OrigamiTeam/AquaFlow/05. Design Mecanico v1.5/readme.md

Arquivo gerado no dia 02/10/2024, referente a versao 1.5 do projeto SmartFlow.

Montagem completa de todos os componentes mecanicos e eletronicos.

Fusion versão 2.0.20256 x86_64
