OrigamiTeam/AquaFlow/Display E-Paper/E-Paper_code/128x296px - V3.jpg

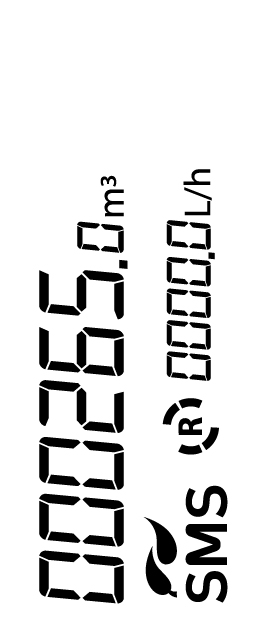
Display E-Paper/E-Paper_code/128x296px - V3.jpg
