OrigamiTeam/AquaFlow/01. AquaFlow v0.2/BOM AquaFlow v0.2 01.10.24.xlsx

Bill Of Materials for AquaFlow v0.2
Category | Quantity | References | Value | Link
Capacitors | 2 | C1, C2 | CAP CER 0805 22pF | https://www.tme.eu/pt/details/c0805c220j5gac/capacitores-mlcc-smd/kemet/c0805c220j5gactu/
Capacitors | 14 | C3, C4, C8, C9, C10, C11, C12, C16, C17, C26, C31, C32, C33, C41 | CAP CER 0805 100nF | https://www.tme.eu/pt/details/0805b104k500ct/capacitores-mlcc-smd/walsin/
Capacitors | 2 | C5, C23 | CAP CER 0805 10nF | https://www.tme.eu/pt/details/cl21b103kcannnc/capacitores-mlcc-smd/samsung/
Capacitors | 2 | C6, C22 | CAP CER 0805 2.2uF | https://www.tme.eu/pt/details/cl21b225kafnnne/capacitores-mlcc-smd/samsung/
Capacitors | 1 | C7 | CAP TANT CASE B 10uF/16V | https://www.tme.eu/pt/details/293d106x9025b2te3/capacitores-de-tantalo-smd/vishay/
Capacitors | 4 | C13, C14, C15, C21 | CAP CER 0805 1uF | https://www.tme.eu/pt/details/cl21b105kafnnng/capacitores-mlcc-smd/samsung/
Capacitors | 4 | C24, C25, C27, C28 | CAP CER 0805 12pF | https://www.tme.eu/pt/details/cc0805jrnpo9120/capacitores-mlcc-smd/yageo/cc0805jrnpo9bn120/
Capacitors | 1 | C29 | CAP CER 1206 100nF 1% | https://www.tme.eu/pt/details/gcm31c5c1h104fa16l/capacitores-mlcc-smd/murata/
Capacitors | 1 | C30 | CAP CER 0805 22uF | https://www.tme.eu/pt/details/cl21a226kpclrnc/capacitores-mlcc-smd/samsung/
Capacitors | 2 | C34, C35 | CAP CER 0805 1nF 1% | https://www.tme.eu/pt/details/08055a102fat2a/capacitores-mlcc-smd/kyocera-avx/
Resistors | 7 | R1, R3, R5, R6, R23, R27, R28 | RES 0805 10K | https://www.tme.eu/pt/details/smd0805-10k-1%25/resistencias-smd/royal-ohm/0805s8f1002t5e/
Resistors | 1 | R2 | RES 0805 1M | https://www.tme.eu/pt/details/smd0805-1m-1%25/resistencias-smd/royal-ohm/0805s8f1004t5e/
Resistors | 1 | R4 | RES 0805 100R | https://www.tme.eu/pt/details/smd0805-100r-1%25/resistencias-smd/royal-ohm/0805s8f1000t5e/
Resistors | 1 | R7 | RES 0805 200mR | https://www.tme.eu/pt/details/erj6bsfr20v/resistencias-smd/panasonic/
Resistors | 1 | R8 | RES 0805 4K7 | https://www.tme.eu/pt/details/smd0805-4k7-1%25/resistencias-smd/royal-ohm/0805s8f4701t5e/
Resistors | 1 | R11 | RES 0805 1K | https://www.tme.eu/pt/details/smd0805-1k-1%25/resistencias-smd/royal-ohm/0805s8f1001t5e/
Resistors | 1 | R20 | RES 0805 1K 25ppm/C 0.1% | https://www.tme.eu/pt/details/era6aeb102v/resistencias-smd/panasonic/
Resistors | 2 | R21, R22 | RES 0805 680R | https://www.tme.eu/pt/details/smd0805-680r-1%25/resistencias-smd/royal-ohm/0805s8f6800t5e/
Resistors | 1 | R29 | RES 0805 220R | https://www.tme.eu/pt/details/smd0805-220r-1%25/resistencias-smd/royal-ohm/0805s8f2200t5e/
Resistors | 1 | PTC1 | PTC SMD 1206 250mA 15V | https://www.tme.eu/pt/details/0zcj0025af2e/fusiveis-de-polimero-smd/bel-fuse/
Integrated Circuits | 1 | U1 | 16-HTSSOP DRV8833PWPR | https://www.tme.eu/pt/details/drv8833pw/drivers-de-motor-e-pwm/texas-instruments/
Integrated Circuits | 1 | U3 | 32-TQFP ATMEGA328PB-AU SMD | https://www.tme.eu/pt/details/atmega328pb-au/familia-avr-8-bit/microchip-technology/
Integrated Circuits | 1 | U4 | SOT-23-5 LP2985AIM5-3.3/NOPB | https://www.tme.eu/pt/details/lp2985aim5-3.3nopb/reguladores-de-tensao-nao-regulada-ldo/texas-instruments/lp2985aim5-3-3-nopb/
Integrated Circuits | 1 | U5 | 32-TQFP Exposed Pad MAX35103EHJ+ | https://www.digikey.pt/pt/products/detail/analog-devices-inc-maxim-integrated/MAX35103EHJ/6568908 https://www.digikey.pt/pt/products/detail/analog-devices-inc-maxim-integrated/MAX35103EHJ-T/7392205
Transistors | 1 | Q1 | SOT-23 BC817 | https://www.tme.eu/pt/details/bc817-25-dio/transistores-npn-smd/diotec-semiconductor/bc817-25/
Diodes | 1 | D3 | SMA US1M | https://www.tme.eu/pt/details/us1mtr-smc/diodos-universais-smd/smc-diode-solutions/us1mtr/
Diodes | 1 | D9 | SMB SMBJ12A | https://www.tme.eu/pt/details/p6smbj12a-dio/diodos-transil-smd-unidirecionais/diotec-semiconductor/p6smbj12a/
Diodes | 1 | D-PWR | LED SMD 0805 | https://www.tme.eu/pt/details/ll-s170pgc-g5-1a/diodos-led-smd-de-cores/luckylight/
Connectors | 2 | J1, RTD1 | S2B-PH-SM4-TB | https://www.tme.eu/pt/details/s2b-ph-sm4-tb/conectores-de-sinal-raster-2-00mm/jst/s2b-ph-sm4-tb-lf-sn/
Connectors | 1 | J2 | CONN-SIL6 | DNP (do-not-populate)
Connectors | 1 | J3 | CONN-SIL10 | https://www.tme.eu/pt/details/zl211-20kg-s/pinos-tipo-header/connfly/ds1022-1-20ruf1-1/
Connectors | 1 | J4 | S4B-PH-SM4-TB | https://www.tme.eu/pt/details/s4b-ph-sm4-tb/conectores-de-sinal-raster-2-00mm/jst/s4b-ph-sm4-tb-lf-sn/
Connectors | 1 | J5 | S5B-PH-SM4-TB | https://www.tme.eu/pt/details/s5b-ph-sm4-tb/conectores-de-sinal-raster-2-00mm/jst/s5b-ph-sm4-tb-lf-sn/
Connectors | 1 | J6 | S3B-PH-SM4-TB | https://www.tme.eu/pt/details/s3b-ph-sm4-tb/conectores-de-sinal-raster-2-00mm/jst/s3b-ph-sm4-tb-lf-sn/
LCD | 1 | LCD1 | NHD-C12832A1Z-FSW-FBW-3V3 | https://www.tme.eu/pt/details/nhd-c12832a1z-fwf3/indicadores-graficos-lcd/newhaven-display-international/nhd-c12832a1z-fsw-fbw-3v3/
Miscellaneous | 1 | S1 | CHAVE TACT PTS636 | https://www.tme.eu/pt/details/pts636sk50jsmtrlfs/microcomutadores-tact/c-k/pts636-sk50j-smtr-lfs/
Miscellaneous | 1 | X1 | HC-49 8MHz | https://www.tme.eu/pt/details/8.00m-smdhc49s/cristais-de-quartzo-smd/yic/
Miscellaneous | 1 | X2 | HC-49 4MHz | https://www.tme.eu/pt/details/4.00m-smdhc49s/cristais-de-quartzo-smd/yic/
Miscellaneous | 1 | X3 | SMD 9CAA32768122TF70QT | https://www.tme.eu/pt/details/32.768k12.5pi_3215/cristais-de-quartzo-smd/yic/32-768k12-5pi-3215e/
