OrigamiTeam/AquaFlow/02. Modulo Protocolo LoRa v0.1/BOM Modulo Protocolo LoRa v0.1 01.10.24.xlsx

Bill Of Materials for Modulo Protocolo LoRa v0.1
Category | Quantity | References | Value | Link
Integrated Circuits | 1 | U1 | RFM95W LORA MODULE | https://www.tme.eu/pt/details/rfm95cw-868s2/modulos-de-rf/hope-microelectronics/
Connectors | 1 | J1 | DS1024-1*10R0 | https://www.tme.eu/pt/details/zl263-10sg/pinos-tipo-header/connfly/ds1024-1-10r0/
