OrigamiTeam/AquaFlow/Arquivos Auxiliares/T-2Y2W539394A-5sets-SmartFlow+v0.1+BOM+PCBWay(2024-05-27).xlsx

PCBWay Bom Quotation, Product No.:T-2Y2W539394A
Item # | *Designator | *Qty | *Mfg Part # | *Package/Footprint | *Unit Price(5 sets) | *Total | *Delivery Time | *Actual Purchase Mfg Part # | *PCBWay Note | Customer Reply
1 | C1,C2 | 2 | 22pF | RC0805 | $0.050 | $0.500 |  | CC0805JRNPOYBN220
2 | C3,C4,C5,C8,C16,C19,C26,C31,C32,C33,C39,C40,C41 | 13 | 100nF | RC0805 | $0.016 | $1.040 |  | CC0805ZRY5V9BB104
3 | C6,C9,C10,C17,C20,C23,C37 | 7 | 10nF | RC0805 | $0.011 | $0.385 |  | CC0805KRX7R8BB103
4 | C7,C42 | 2 | 10uF | RC0805 | $0.084 | $0.840 |  | CC0805KKX5R7BB106
5 | C11,C12 | 2 | 51pF | RC0805 | $0.050 | $0.500 |  | CC0805JRNPO9BN510
6 | C13,C34,C35 | 3 | 1nF 1% | RC0805 | $0.050 | $0.750 |  | CC0805FRNPO9BN102
7 | C14,C15 | 2 | 300pF | RC0805 | $0.076 | $0.760 |  | CC0805FRNPO9BN301
8 | C18,C21 | 2 | 1uF | RC0805 | $0.034 | $0.340 |  | CC0805KKX7R6BB105
9 | C22,C43 | 2 | 2.2uF | RC0805 | $0.082 | $0.820 |  | CC0805ZKY5V8BB225
10 | C24,C25,C27,C28 | 4 | 12pF | RC0805 | $0.010 | $0.200 |  | CC0805JRNPO9BN120
11 | C29 | 1 | 100nF 1206 1% | RC1206 | $1.239 | $6.195 |  | GRM31C5C1H104FA01L
12 | C30,C38 | 2 | 22uF | RC0805 | $0.092 | $0.920 |  | CC0805ZKY5V5BB226
13 | C36 | 1 | 10uF 1206 | RC1206 | $0.147 | $0.735 |  | CC1206KKX5R8BB106
14 | C44 | 1 | 6.8pF | RC0805 | $0.050 | $0.250 |  | CC0805CRNPO9BN6R8
15 | PTC1,PTC2 | 2 | 1206 250mA | RC1206 | $0.248 | $2.480 |  | 0ZCJ0025AF2E
16 | R1,R3,R5,R23,R25,R27,R28,R32,R33,R34 | 10 | 10K | RC0805 | $0.005 | $0.250 |  | RC0805JR-0710KL
17 | R2 | 1 | 1M | RC0805 | $0.036 | $0.180 |  | RC0805JR-071ML
18 | R4,R15,R16,R17 | 4 | 33R | RC0805 | $0.003 | $0.060 |  | RC0805JR-0733RL
19 | R6,R7 | 2 | 10M | RC0805 | $0.006 | $0.060 |  | RC0805FR-0710ML
20 | R8 | 1 | 5K36 1% | RC0805 | $0.050 | $0.250 |  | AC0805FR-075K36L
21 | R9,R10 | 2 | 1K 1% | RC0805 | $0.026 | $0.260 |  | RC0805FR-071KL
22 | R11,R12 | 2 | 0R | RC0805 | $0.006 | $0.060 |  | RC0805JR-070RL
23 | R13,R14,R18,R24,R26,R29 | 6 | 200R | RC0805 | $0.025 | $0.750 |  | AC0805JR-07200RL
24 | R19 | 1 | 102K 1% | RC0805 | $0.042 | $0.210 |  | RTT051023FTP
25 | R20 | 1 | 1K 25ppm/C 0.1% | RC0805 | $0.147 | $0.735 |  | RT0805BRD071KL
26 | R21,R22 | 2 | 680R | RC0805 | $0.006 | $0.060 |  | RC0805FR-07680RL
27 | R30 | 1 | 45K3 1% | RC0805 | $0.084 | $0.420 |  | RT0805FRE0745K3L
28 | R31 | 1 | 10K 1% | RC0805 | $0.042 | $0.210 |  | AC0805FR-0710KL
29 | R35 | 1 | 51K1 1% | RC0805 | $0.013 | $0.065 |  | RC0805FR-0751K1L
30 | D1,D4,D5,D-PWR | 4 | LED 0805 | RC0805 | $0.005 | $0.100 |  | XL-2012UGC | https://atta.szlcsc.com/upload/public/pdf/source/20240218/10747BE0D5713A87F194700A6CFFD889.pdf
31 | D3,D6 | 2 | US1M | SMA | $0.126 | $1.260 |  |  | Manufacturer：SMC.Package：DO-214AC（SMA）
32 | D7 | 1 | SMBJ5.0A | SMB | $0.408 | $2.040 |  |  | Manufacturer: SMC.Package：DO-214AA（SMB）
33 | D9 | 1 | SMBJ12A | SMB | $0.214 | $1.070 |  |  | Manufacturer:Littelfuse.Package：SMB(DO-214AA)
34 | FB1,FB2,FB3 | 3 | BK1608HS600 | RC0603 | $0.105 | $1.575 |  | BK1608HS600-T | Package：0603
35 | U1 | 1 | TDC1000PW | 28-TSSOP | $3.045 | $15.225
36 | U2 | 1 | TDC7200PW | 14-TSSOP | $1.376 | $6.880
37 | U3 | 1 | ATMEGA328PB-AU SMD | 32-TQFP | $1.859 | $9.295
38 | U4 | 1 | LP2985AIM5-3.3/NOPB | SOT-23-5 | $0.410 | $2.050
39 | U5 | 1 | MAX35103EHJ+ | 32-TQFP Exposed Pad | $10.248 | $51.240
40 | U6 | 1 | MAX8902BATA+T | 8-WFDFN Exposed Pad | $0.557 | $2.785
41 | U7 | 1 | ESP32-WROOM-32E | 38-SMD Module | $3.590 | $17.950 |  | ESP32-WROOM-32E-N16
42 | U10 | 1 | LP2980IM5X-ADJ/NOPB | SOT-23-5 | $1.092 | $5.460
43 | S1,S2 | 2 | PTS636 |  | $0.158 | $1.580 | 7-10 Workdays | PTS636 SL50 SMTR LFS
44 | X1 | 1 | 8MHz | HC-49 | $0.222 | $1.110 |  | ABLS-8.000MHZ-B4-T
45 | X2 | 1 | 4MHz | HC-49 | $0.232 | $1.160 |  | ABLS-4.000MHZ-B2-T
46 | X3 | 1 | ABS25-32.768KHZ-T | 4-SOJ | $0.408 | $2.040
47 | Y1 | 1 | ASEMB-8.000MHZ-XY-T | 4-SMD | $5.226 | $26.130 | 7-10 Workdays
 |  |  |  |  | Component Cost | $169.24
