OrigamiTeam/AquaFlow/02. Modulo Protocolo LoRa v0.1/Modulo Protocolo LoRa v0.2.STEP

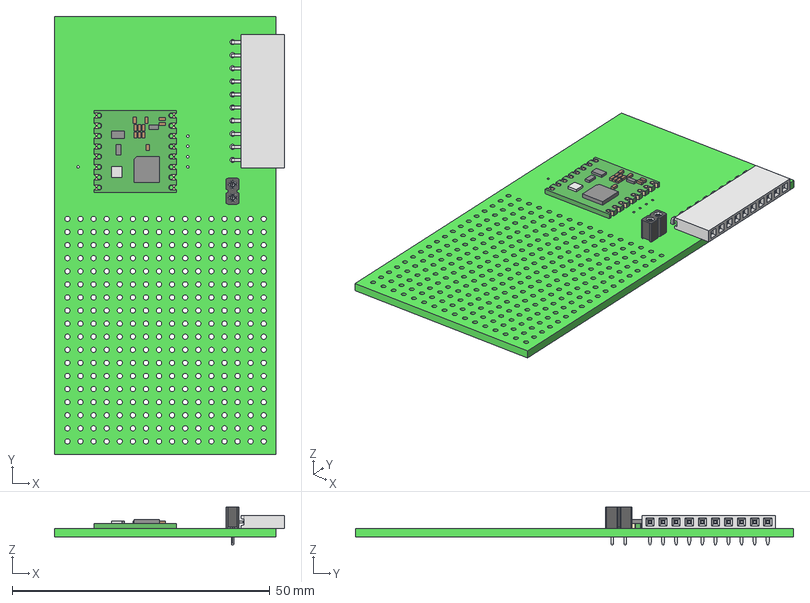
[picture p2: CAD file, 2024-09-12]
02. Modulo Protocolo LoRa v0.1/Modulo Protocolo LoRa v0.2.STEP
44.7 x 85.0 x 7.37 mm
Layer_1
=>[0:1:1:3] x 2
=>[0:1:1:4] x 2
=>[0:1:1:5] x 2
=>[0:1:1:6] x 2
=>[0:1:1:7] x 2
=>[0:1:1:8] x 2
=>[0:1:1:9] x 2
=>[0:1:1:10] x 2
=>[0:1:1:11] x 2
=>[0:1:1:12] x 2
=>[0:1:1:13] x 2
=>[0:1:1:14]
=>[0:1:1:15]
=>[0:1:1:16]
=>[0:1:1:17]
=>[0:1:1:18]
=>[0:1:1:19]
=>[0:1:1:20]
=>[0:1:1:21]
=>[0:1:1:22]
=>[0:1:1:23]
=>[0:1:1:24]
=>[0:1:1:25]
=>[0:1:1:26]
=>[0:1:1:27]
=>[0:1:1:28]
=>[0:1:1:29]
=>[0:1:1:30]
=>[0:1:1:31]
=>[0:1:1:32]
=>[0:1:1:33]
=>[0:1:1:34]
=>[0:1:1:35]
