OrigamiTeam/AquaFlow/01. AquaFlow v0.2/AquaFlow v0.2 SCH 03.09.24.PDF

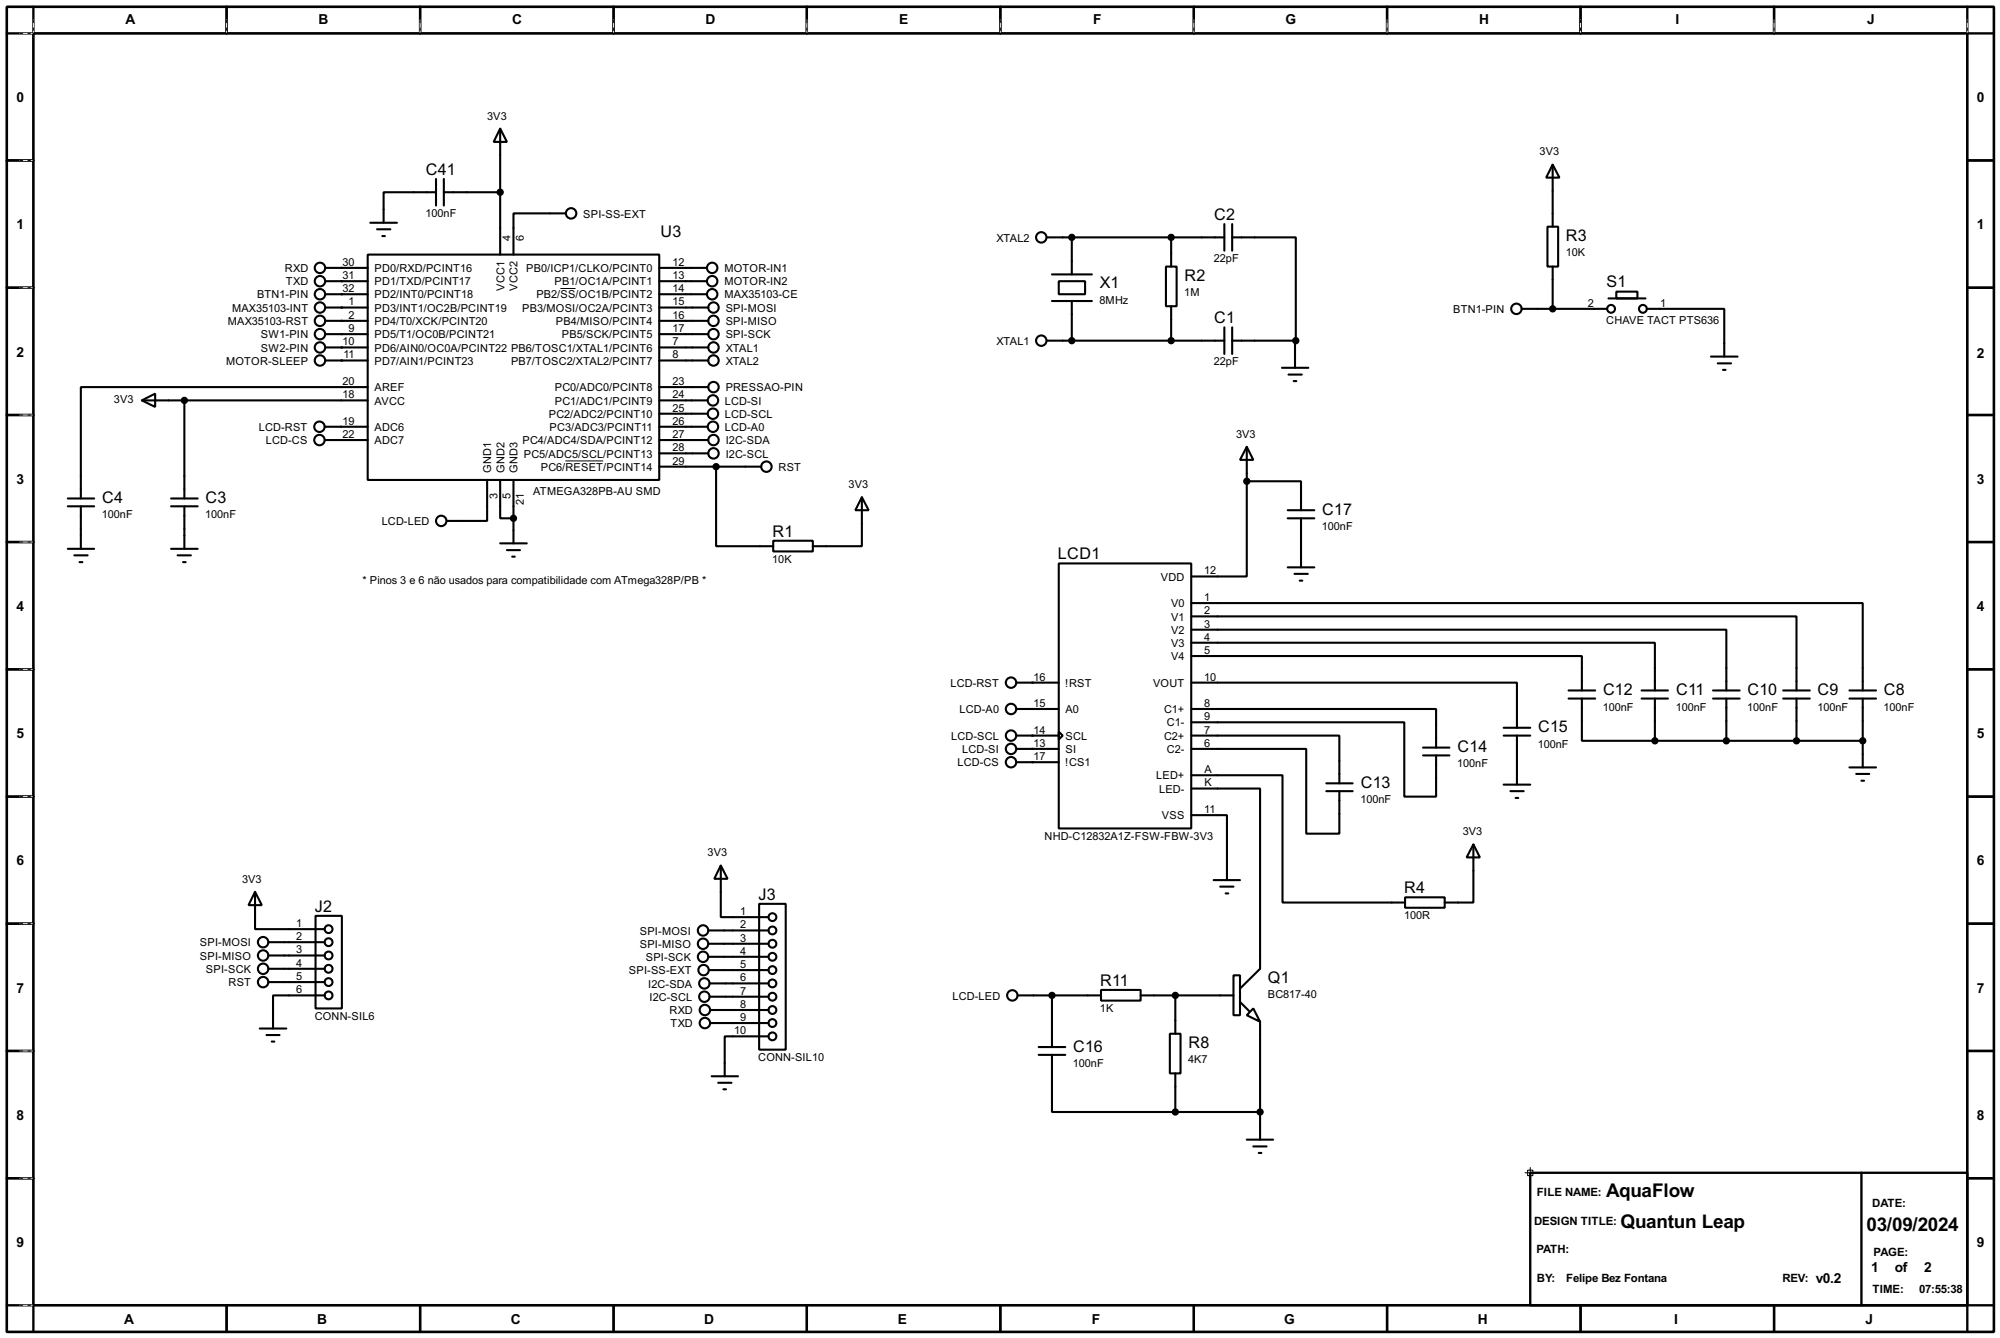
[picture p3: page 1]

* Pinos 3 e 6 não usados para compatibilidade com ATmega328P/PB *

2 V2
3 V3
4 V4 5

DESIGN TITLE:Quantun Leap

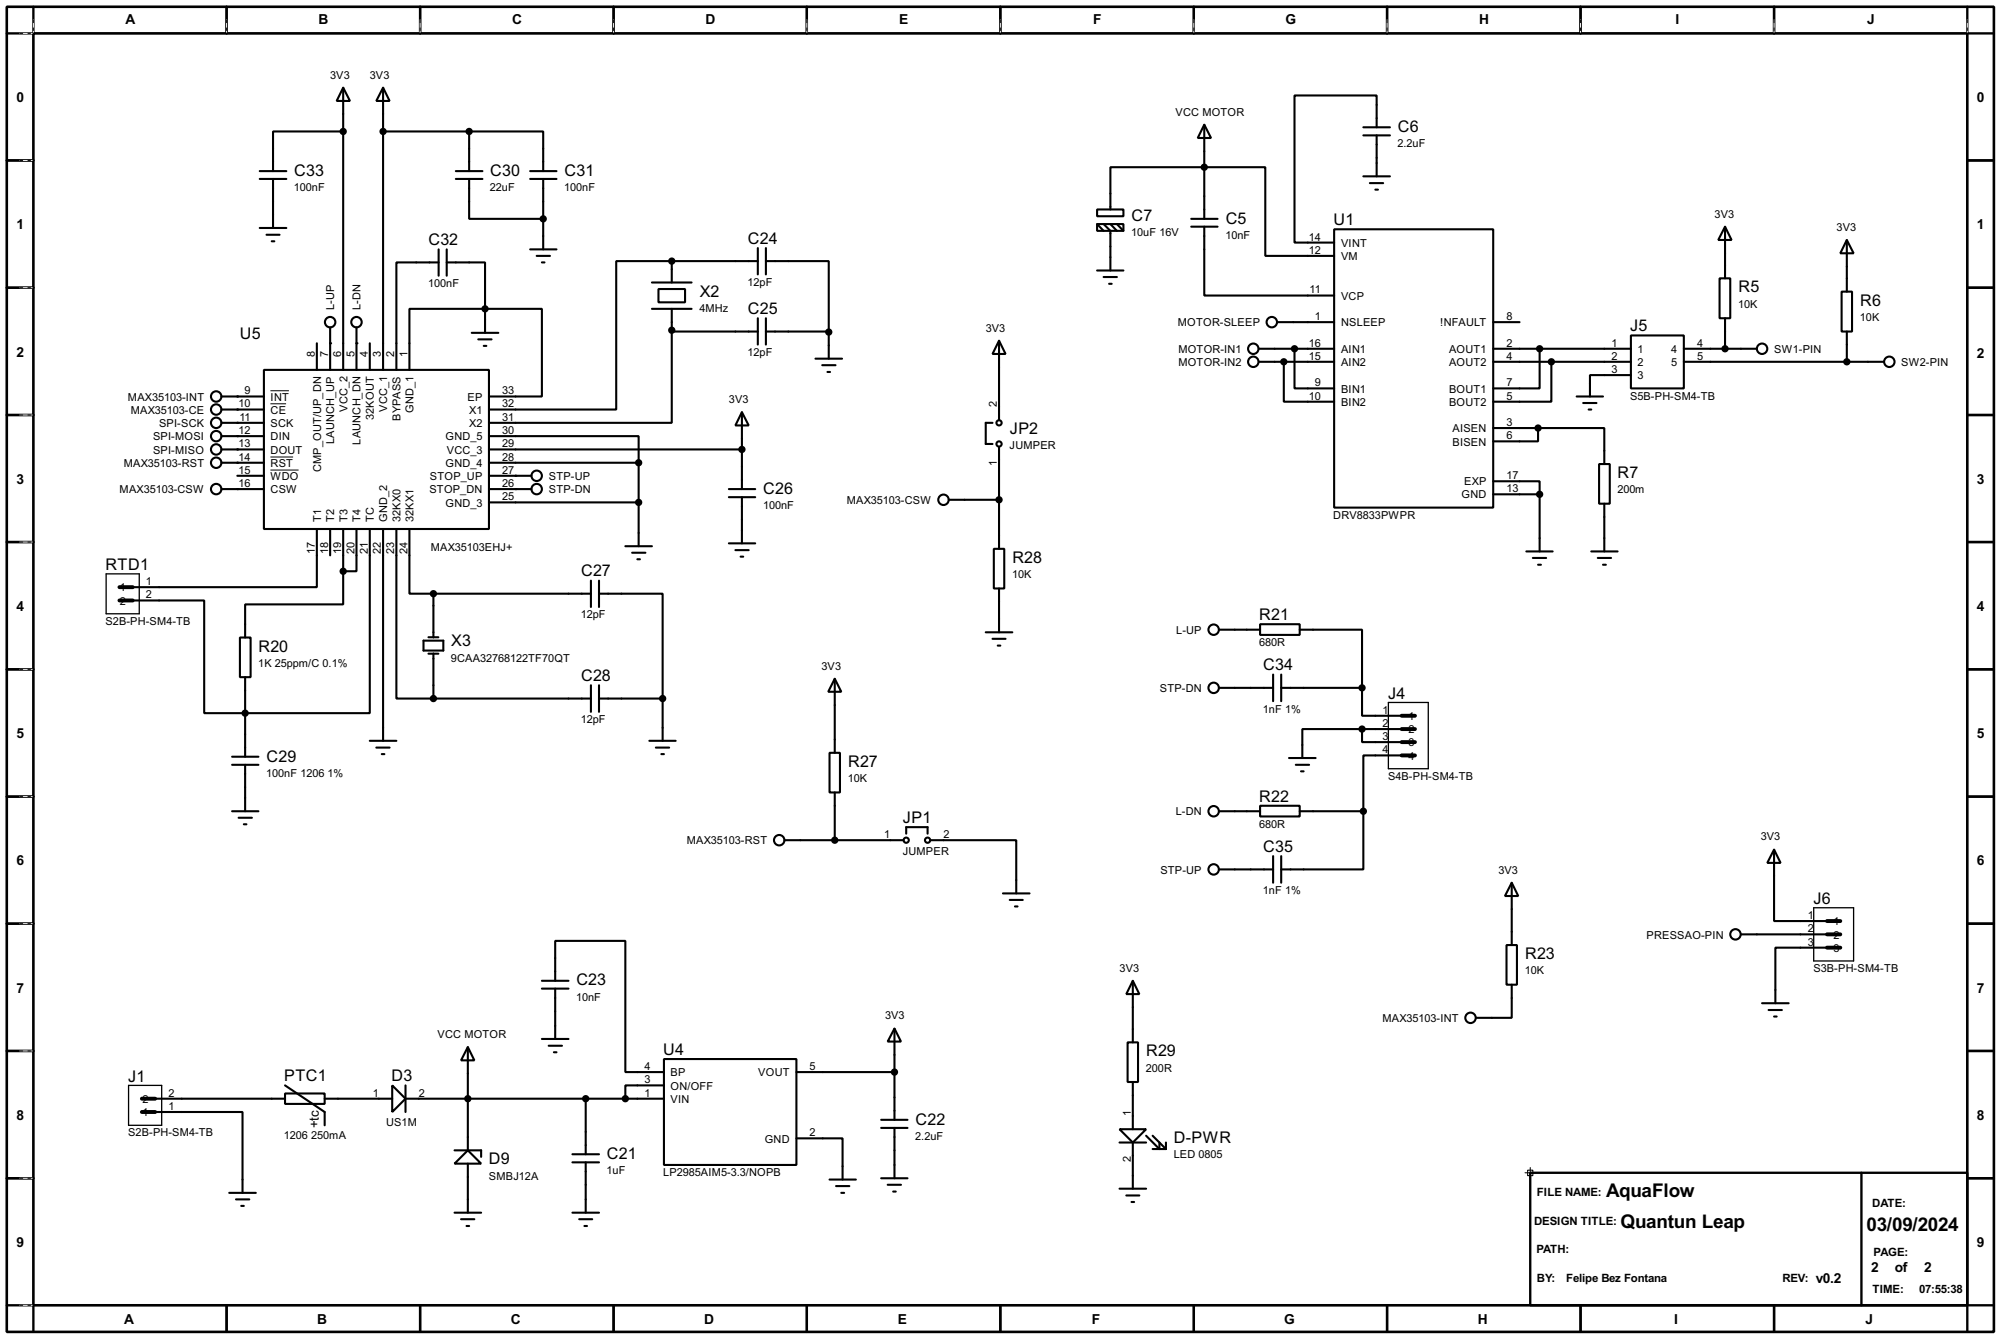
[picture p4: page 2]

4MHz

SPI-MOSI SPI-MISO MAX35103-RST MAX35103-CSW

30 VCC_3
29 GND_4

DESIGN TITLE:Quantun Leap
