OrigamiTeam/AquaFlow/PCB SmartFlow v0.1/SmartFlow v0.1 SCH.PDF

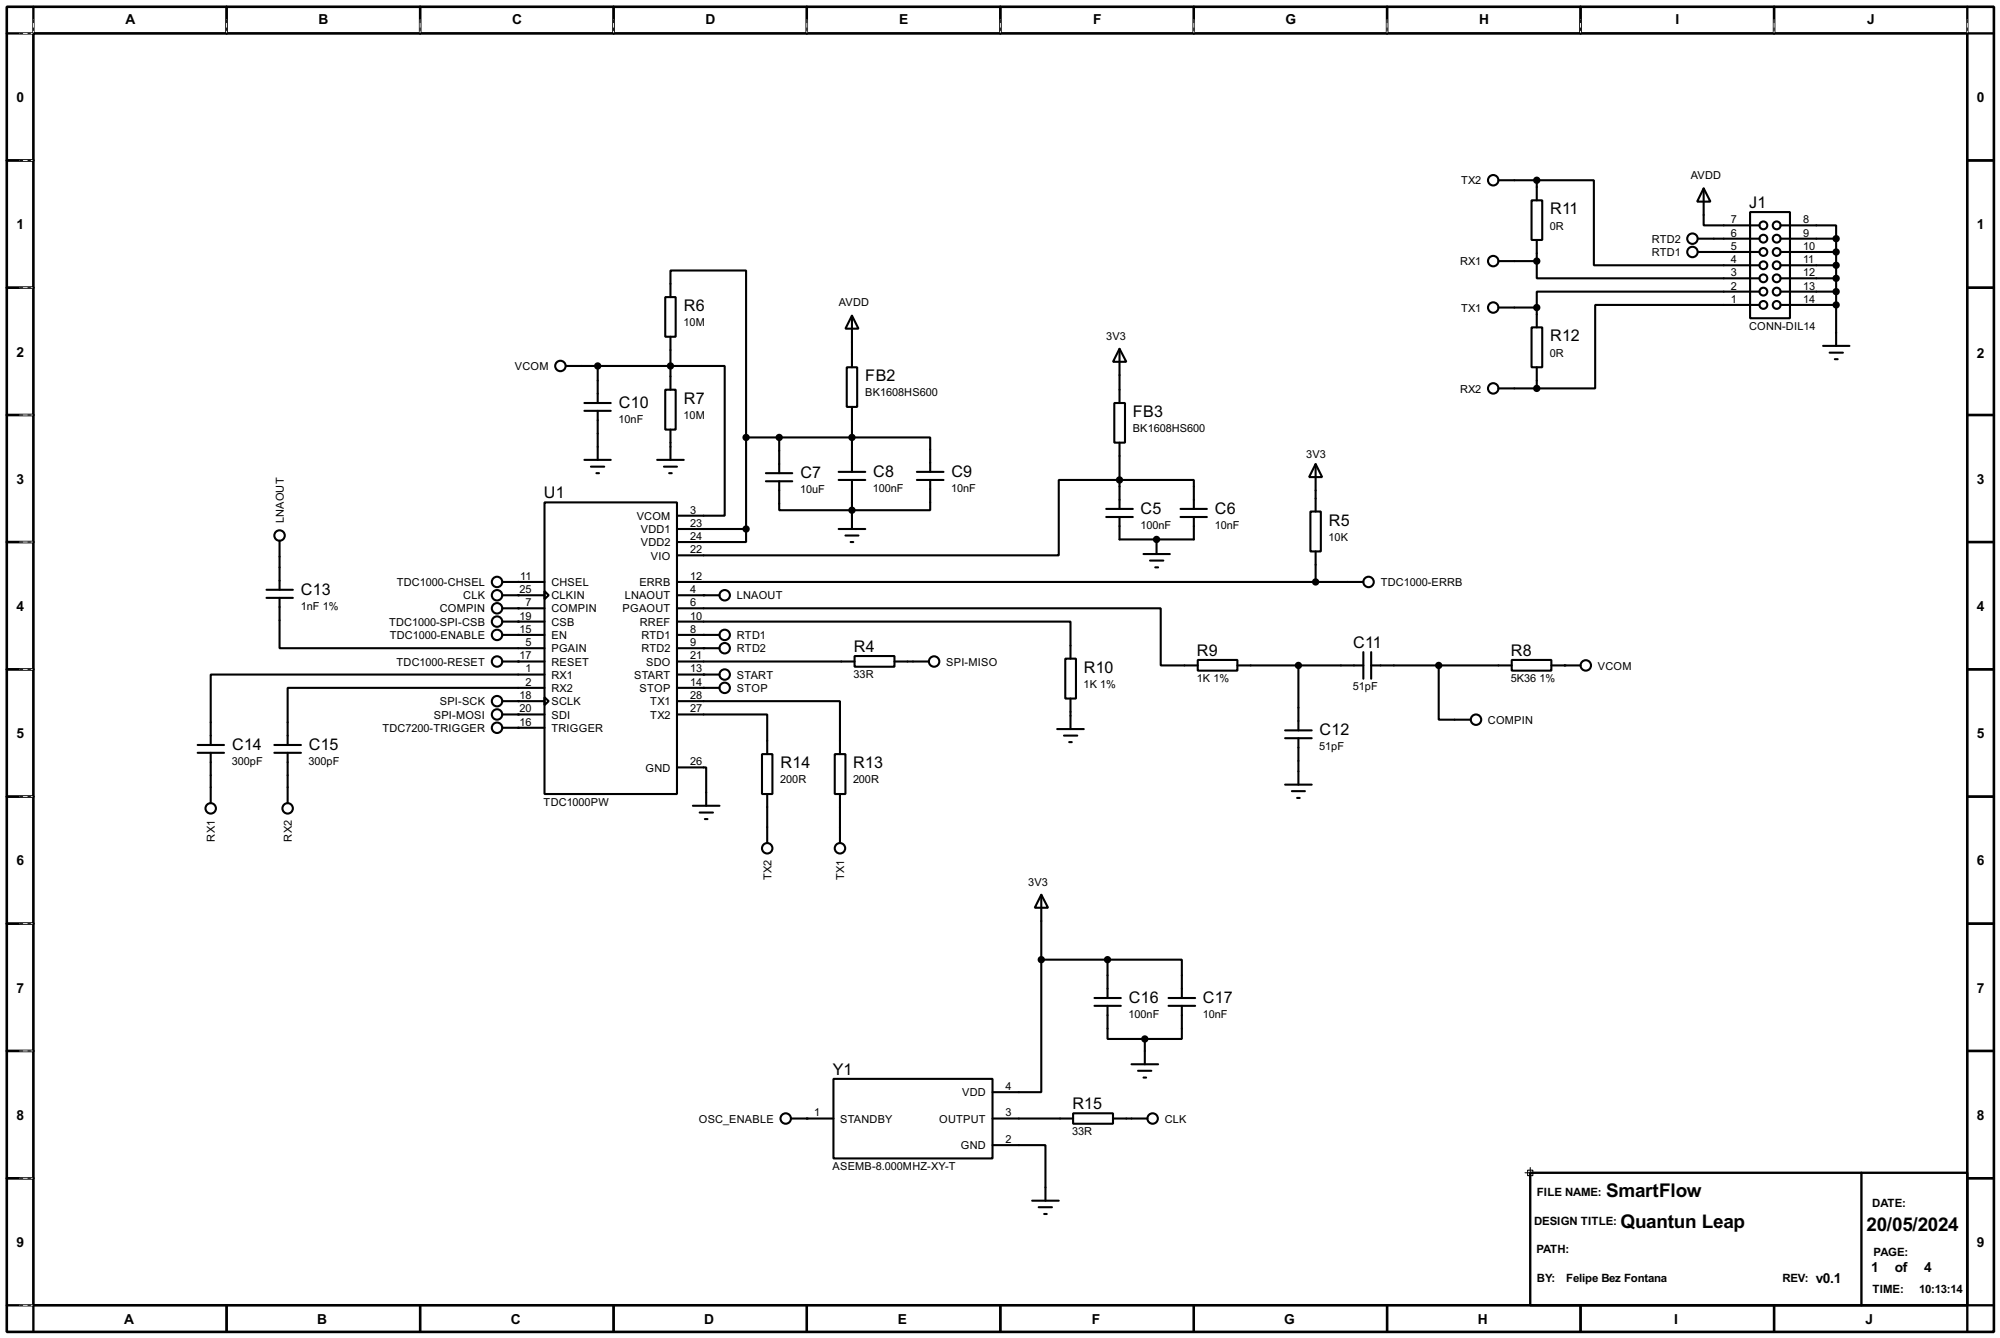
[picture p5: page 1]

SPI-MOSI SPI-SCK | 28 TX2

DESIGN TITLE:Quantun Leap

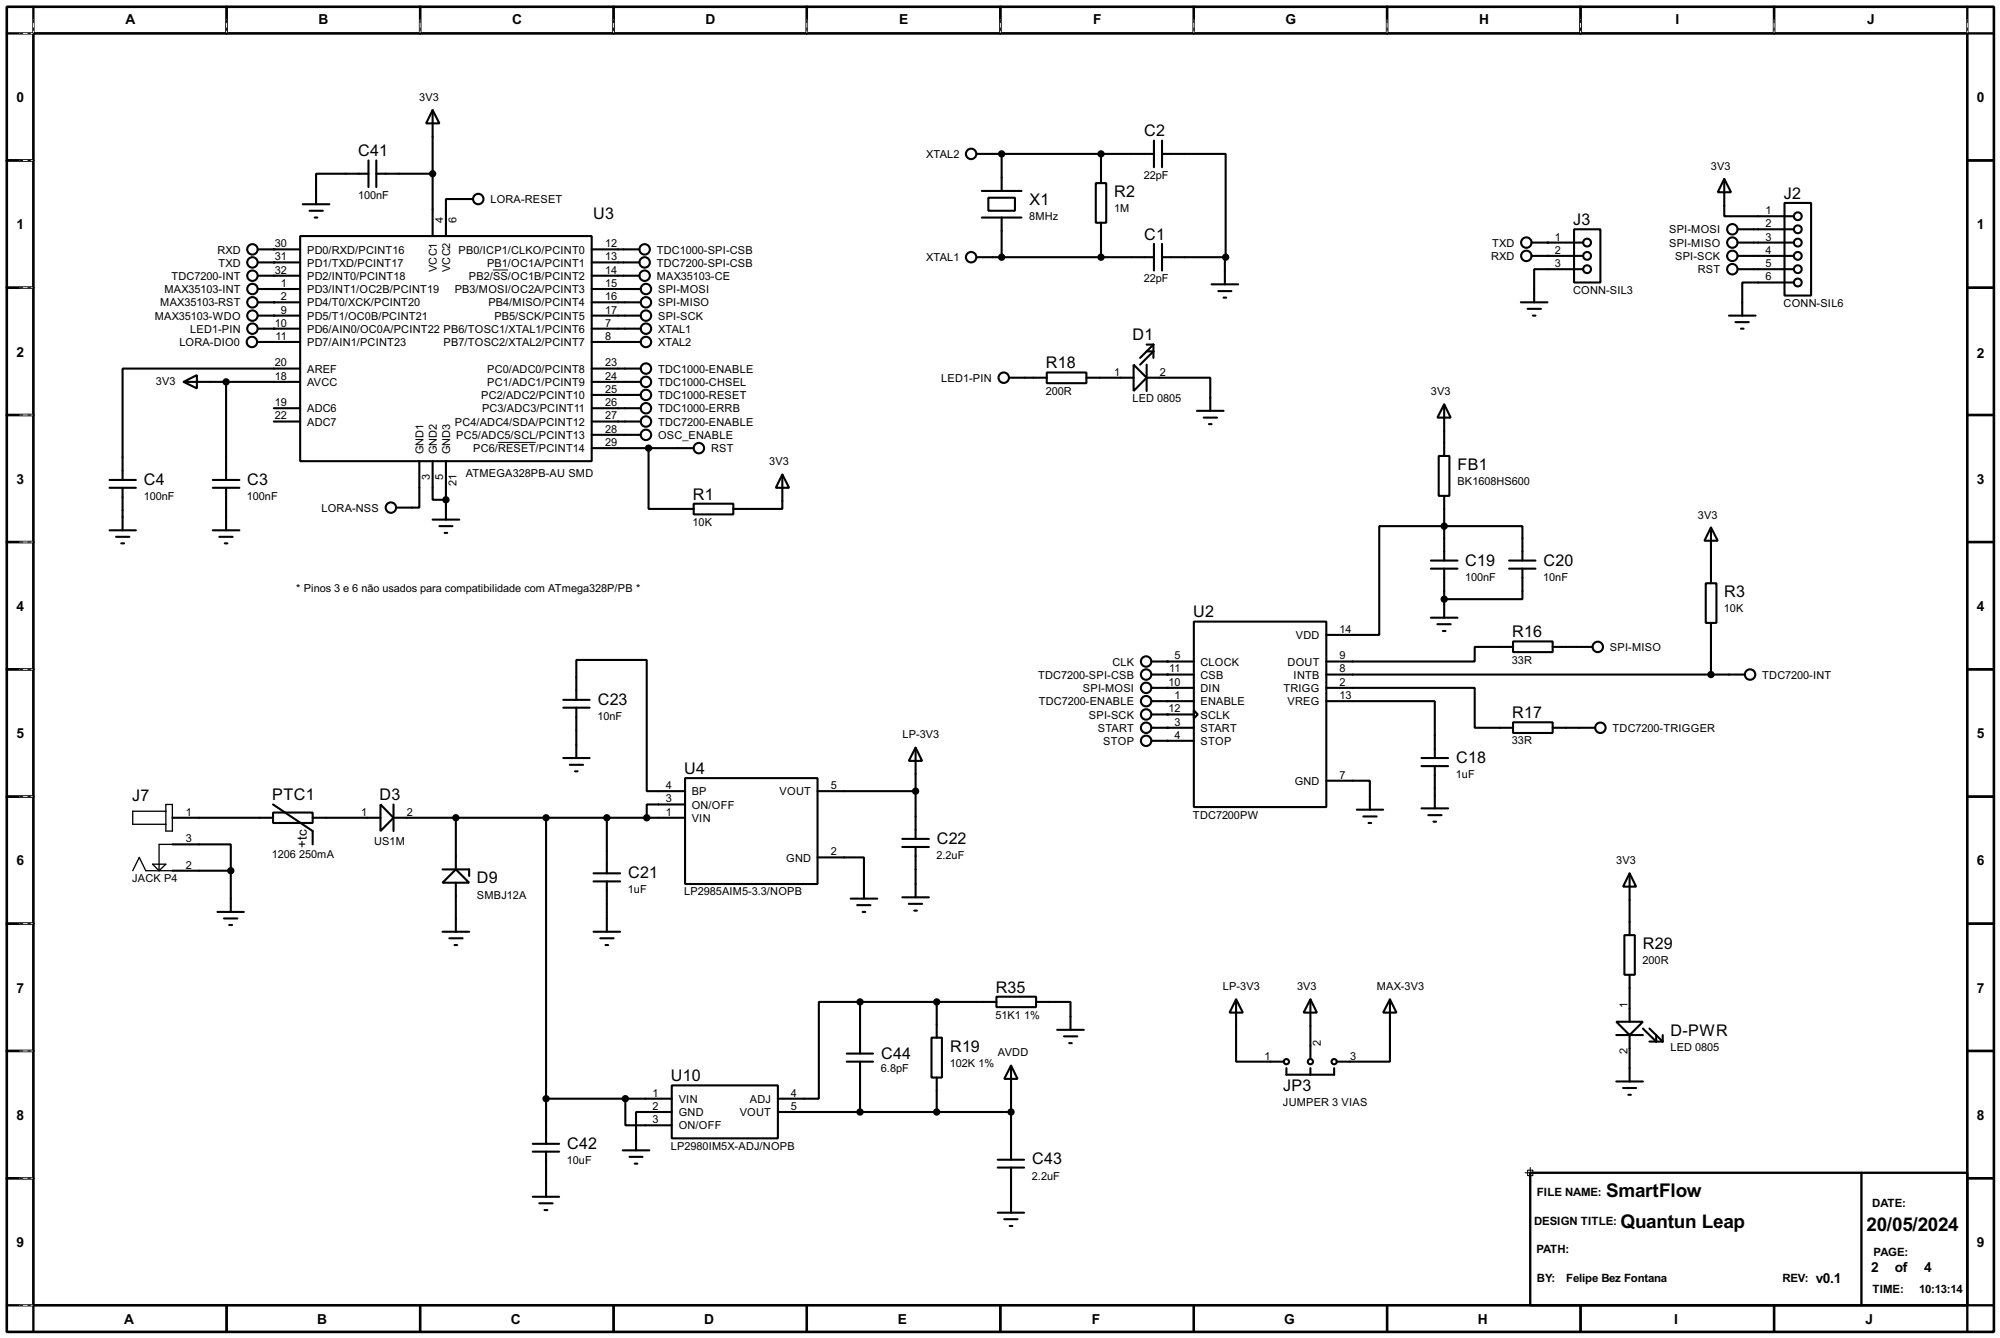
[picture p6: page 2]

* Pinos 3 e 6 não usados para compatibilidade com ATmega328P/PB *

DESIGN TITLE:Quantun Leap

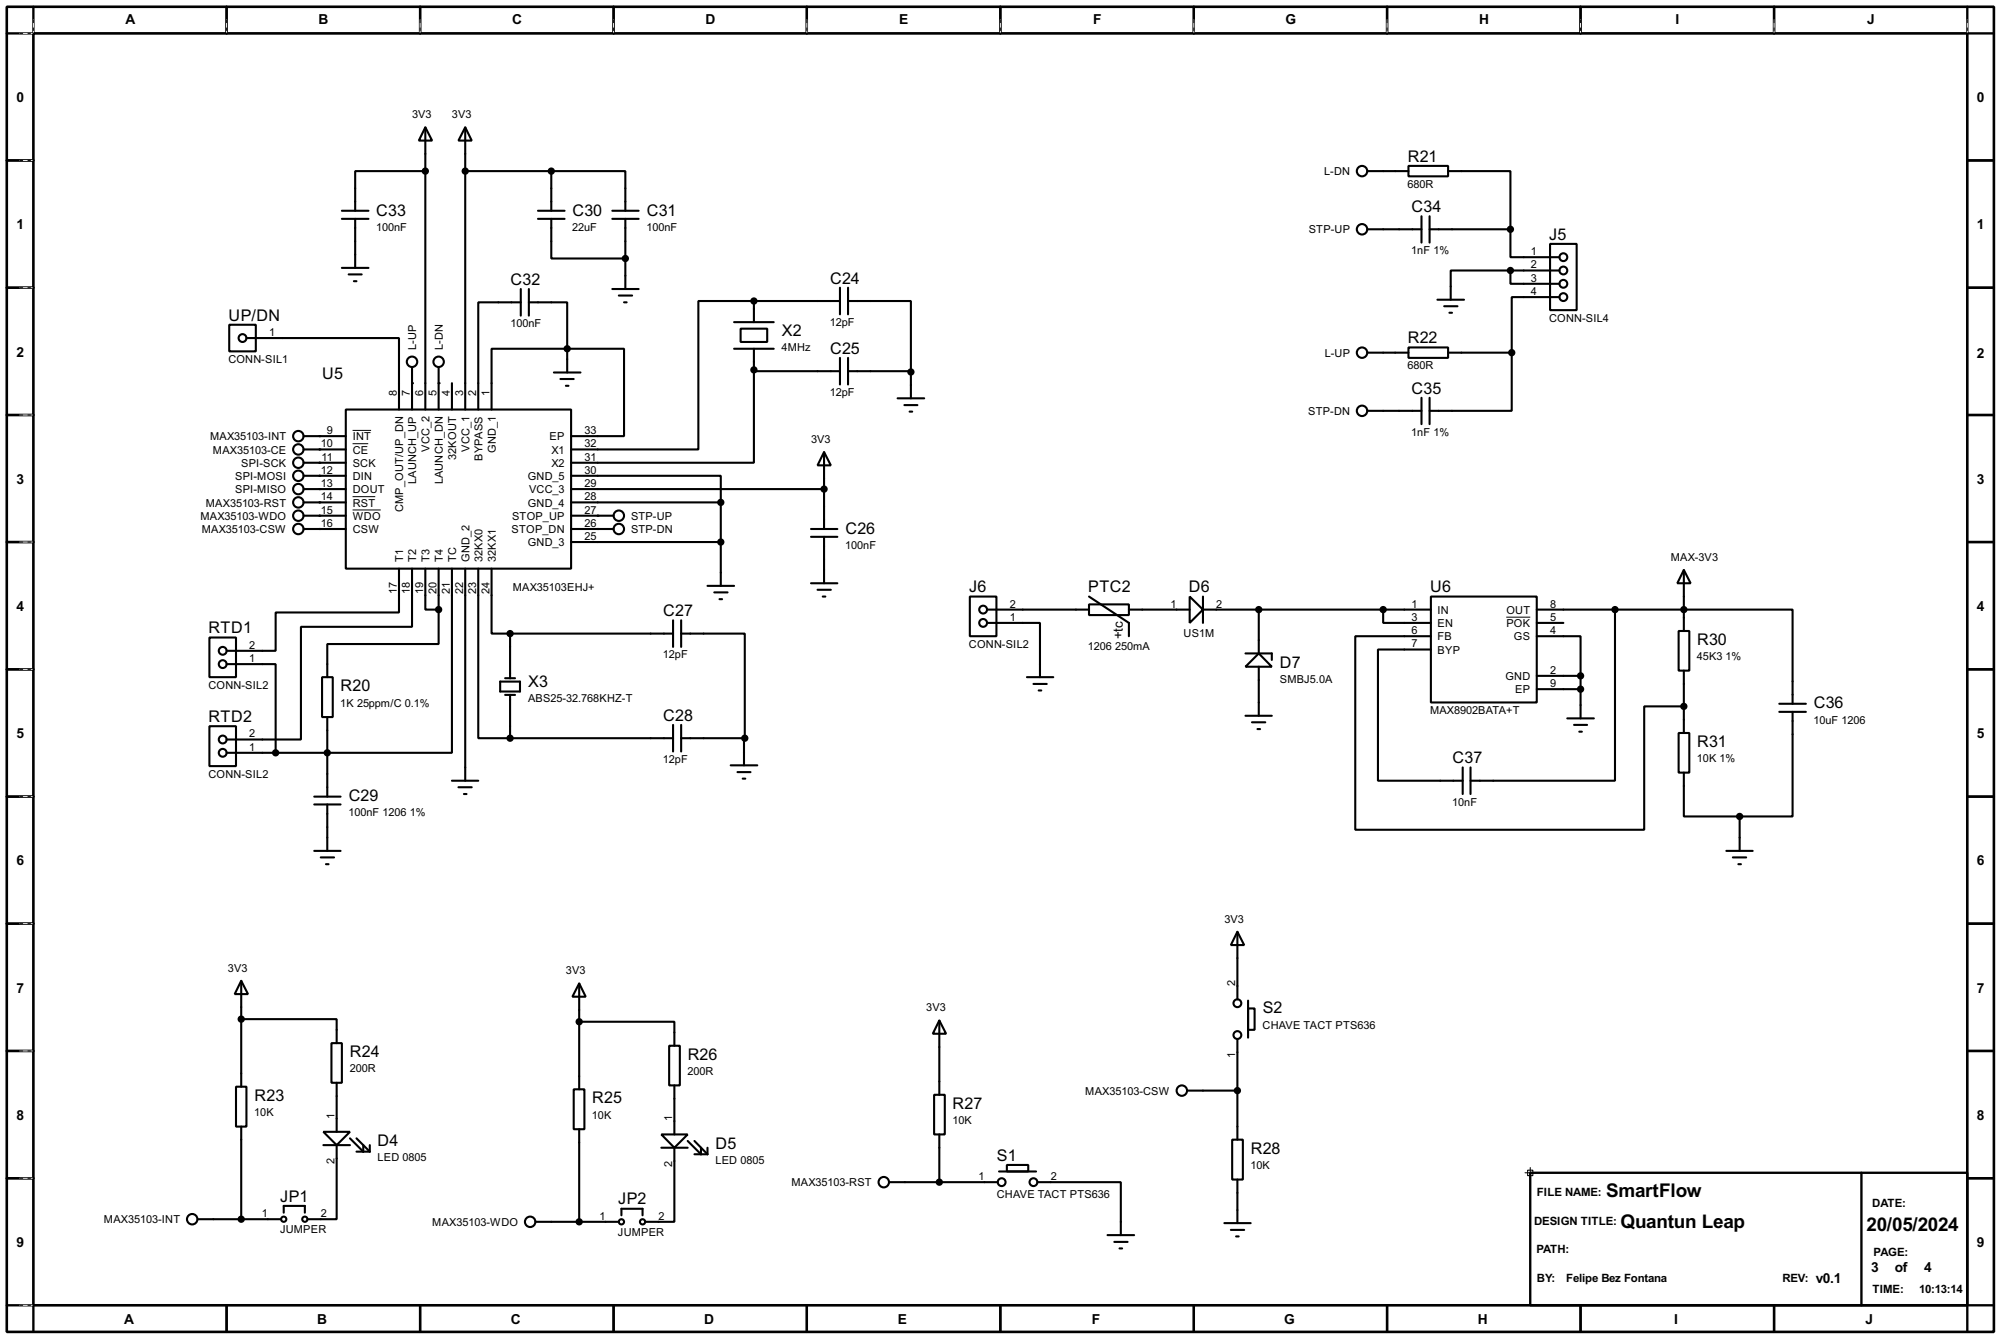
[picture p7: page 3]

STP-DN MAX35103-INT MAX35103-CE

SPI-MOSI SPI-MISO MAX35103-RST MAX35103-WDO MAX35103-CSW

DESIGN TITLE:Quantun Leap

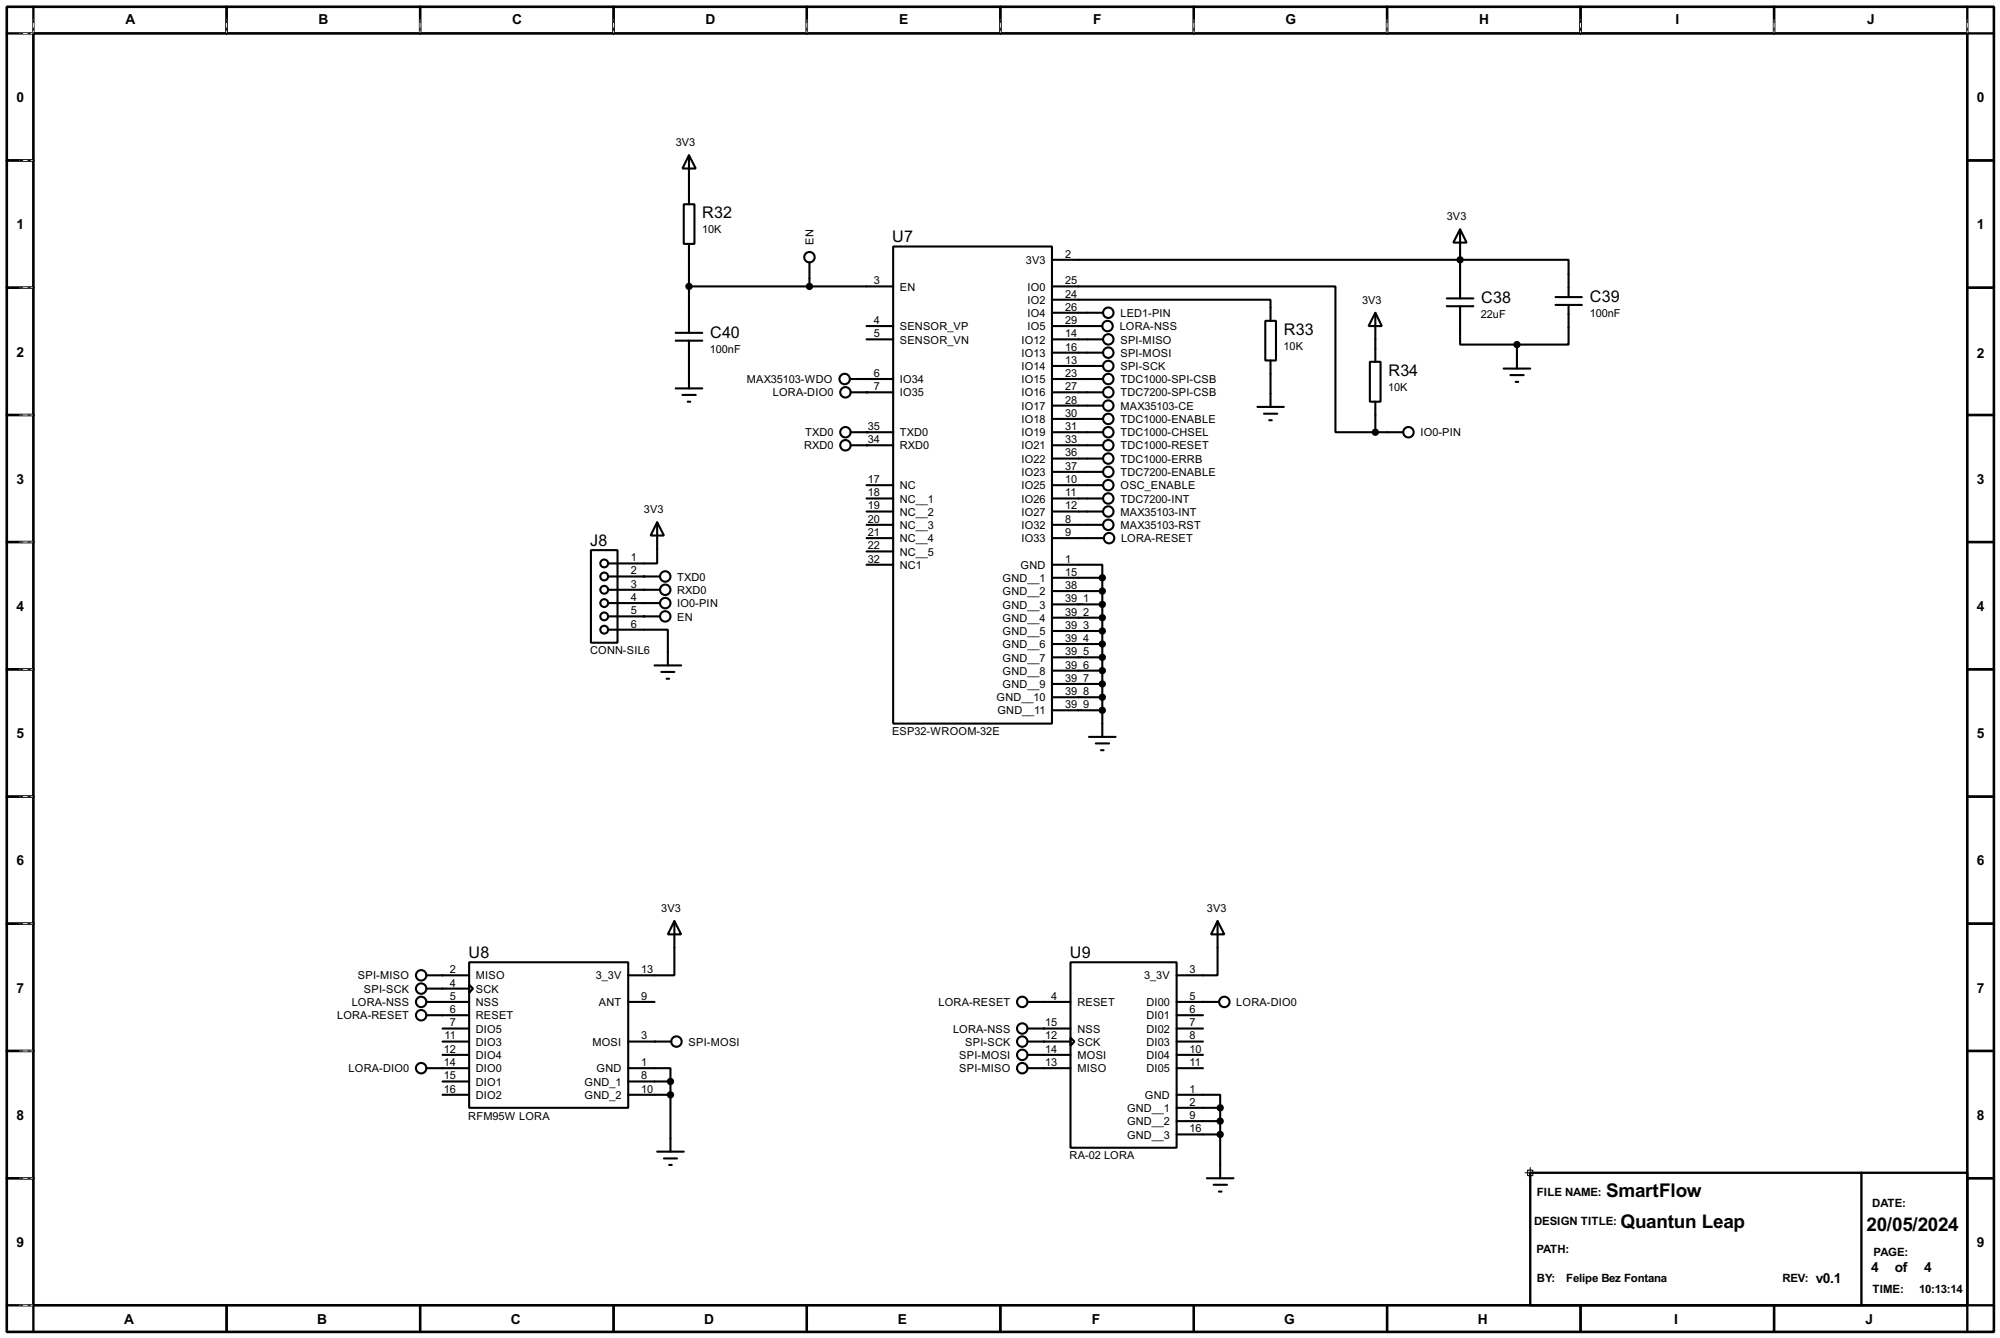
[picture p8: page 4]

25
24
26

DESIGN TITLE:Quantun Leap
