OrigamiTeam/AquaFlow/(list of files, drawings)

Other design files:
01. AquaFlow v0.2/AquaFlow v0.2.pdsprj
01. AquaFlow v0.2/Project Backups/AquaFlow v0.2 [20240903, 07-31-48].pdsprj
01. AquaFlow v0.2/Project Backups/AquaFlow v0.2 [20240903, 07-32-56].pdsprj
01. AquaFlow v0.2/Project Backups/AquaFlow v0.2 [20240903, 07-33-39].pdsprj
01. AquaFlow v0.2/Project Backups/AquaFlow v0.2 [20240903, 07-35-05].pdsprj
01. AquaFlow v0.2/Project Backups/AquaFlow v0.2 [20240903, 07-35-08].pdsprj
01. AquaFlow v0.2/Project Backups/AquaFlow v0.2 [20240903, 07-51-51].pdsprj
01. AquaFlow v0.2/Project Backups/AquaFlow v0.2 [20240903, 07-52-11].pdsprj
01. AquaFlow v0.2/Project Backups/AquaFlow v0.2 [20240903, 07-52-15].pdsprj
01. AquaFlow v0.2/Project Backups/AquaFlow v0.2 [20240903, 07-55-38].pdsprj
01. AquaFlow v0.2/Project Backups/AquaFlow v0.2 [20240903, 10-15-48].pdsprj
02. Modulo Protocolo LoRa v0.1/Modulo Protocolo LoRa v0.1.pdsprj
02. Modulo Protocolo LoRa v0.1/Project Backups/Modulo Protocolo LoRa v0.1 [20240903, 05-50-41].pdsprj
02. Modulo Protocolo LoRa v0.1/Project Backups/Modulo Protocolo LoRa v0.1 [20240903, 05-52-53].pdsprj
02. Modulo Protocolo LoRa v0.1/Project Backups/Modulo Protocolo LoRa v0.1 [20240903, 05-54-11].pdsprj
02. Modulo Protocolo LoRa v0.1/Project Backups/Modulo Protocolo LoRa v0.1 [20240903, 05-54-18].pdsprj
02. Modulo Protocolo LoRa v0.1/Project Backups/Modulo Protocolo LoRa v0.1 [20240903, 05-54-33].pdsprj
02. Modulo Protocolo LoRa v0.1/Project Backups/Modulo Protocolo LoRa v0.1 [20240903, 05-57-26].pdsprj
02. Modulo Protocolo LoRa v0.1/Project Backups/Modulo Protocolo LoRa v0.1 [20240903, 05-58-06].pdsprj
02. Modulo Protocolo LoRa v0.1/Project Backups/Modulo Protocolo LoRa v0.1 [20240903, 05-58-11].pdsprj
02. Modulo Protocolo LoRa v0.1/Project Backups/Modulo Protocolo LoRa v0.1 [20240903, 05-59-20].pdsprj
02. Modulo Protocolo LoRa v0.1/Project Backups/Modulo Protocolo LoRa v0.1 [20240903, 06-10-08].pdsprj
PCB SmartFlow v0.1/Project Backups/SmartFlow v0.1 [20240507, 19-59-03].pdsprj
PCB SmartFlow v0.1/Project Backups/SmartFlow v0.1 [20240507, 19-59-58].pdsprj
PCB SmartFlow v0.1/Project Backups/SmartFlow v0.1 [20240507, 20-02-23].pdsprj
PCB SmartFlow v0.1/Project Backups/SmartFlow v0.1 [20240509, 10-16-51].pdsprj
PCB SmartFlow v0.1/Project Backups/SmartFlow v0.1 [20240509, 10-20-16].pdsprj
PCB SmartFlow v0.1/Project Backups/SmartFlow v0.1 [20240509, 10-29-36].pdsprj
PCB SmartFlow v0.1/Project Backups/SmartFlow v0.1 [20240509, 10-31-38].pdsprj
PCB SmartFlow v0.1/Project Backups/SmartFlow v0.1 [20240509, 10-41-41].pdsprj
PCB SmartFlow v0.1/Project Backups/SmartFlow v0.1 [20240520, 10-12-47].pdsprj
PCB SmartFlow v0.1/Project Backups/SmartFlow v0.1 [20240520, 10-13-14].pdsprj
PCB SmartFlow v0.1/SmartFlow v0.1.pdsprj
