OrigamiTeam/AquaFlow/03. Firmware AquaFlow v0.3/src/main.cpp

#include <Arduino.h>
#include <SPI.h>
#include <LoRa.h>

#include <avr/pgmspace.h>

#include "MAX35103.h"
#include "valvulaMotorDC.h"
#include "displayST7565R.h"

#define DEBUG true

// Pino para botao com acesso externo
#define btnPin 2

// Pinos para interface com MAX35103
#define MAX35103INT 3
#define MAX35103RST 4
#define MAX35103CE 10

// Pinos para acionamento do driver de motor DC e sensores fim de curso
#define SW1Pin 5
#define SW2Pin 6
#define motorSleepPin 7
#define motorIN1Pin 8
#define motorIN2Pin 9

// Pino para leitura analogica do sensor de pressao
#define pressaoPin 14

// Pinos para interface com display NHD-C12832A1Z-FSW-FBW-3V3
#define LCD_SI 15
#define LCD_SCL 16
#define LCD_A0 17
#define LCD_LED 23
#define LCD_RST 25
#define LCD_CS 26

// Pinos para interface externa com modulos de comunicacao (SPI compartilhado com SS dedicado, RS-232 dedicado e I2C dedicado)
#define RS232_RX_EXT 0
#define RX232_TX_EXT 1
#define I2C_SDA_EXT 18
#define I2C_SCL_EXT 19
#define SPI_SS_EXT 24

// ### MODULO LoRa ###

#define LoRaSS I2C_SDA_EXT
#define LoRaRST I2C_SCL_EXT
#define LoRaDIO0 SPI_SS_EXT

#define tempoInfoLCD 10000

#define qtdAvisos 30
#define avisoInicio 0x1001

#define timeoutValvula 15000

const unsigned char numeros [10][56] PROGMEM = {
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

const unsigned char simboloAviso [2][100] PROGMEM = {
  {0x00, 0x00, 0x00, 0x00, 0x00, 0x00, 0x00, 0x00, 0x80, 0xE0, 0x70, 0x18, 0x18, 0x18, 0x70, 0xE0, 0x80, 0x00, 0x00, 0x00, 0x00, 0x00, 0x00, 0x00, 0x00, 0x00, 0x00, 0x00, 0x00, 0x80, 0xE0, 0x78, 0x1E, 0x07, 0x01, 0x00, 0xFC, 0xFC, 0xFC, 0x00, 0x01, 0x07, 0x1E, 0x78, 0xE0, 0x80, 0x00, 0x00, 0x00, 0x00, 0x80, 0xE0, 0x78, 0x1E, 0x07, 0x01, 0x00, 0x00, 0x00, 0x00, 0x00, 0xE7, 0xE7, 0xE7, 0x00, 0x00, 0x00, 0x00, 0x00, 0x01, 0x07, 0x1E, 0x78, 0xE0, 0x80, 0x03, 0x07, 0x0E, 0x0C, 0x0C, 0x0C, 0x0C, 0x0C, 0x0C, 0x0C, 0x0C, 0x0C, 0x0C, 0x0C, 0x0C, 0x0C, 0x0C, 0x0C, 0x0C, 0x0C, 0x0C, 0x0C, 0x0E, 0x07, 0x03},
  {0x00, 0x00, 0x00, 0x80, 0xC0, 0xE0, 0xE0, 0xF0, 0xF0, 0xF8, 0xF8, 0xF8, 0xF8, 0xF8, 0xF8, 0xF8, 0xF0, 0xF0, 0xE0, 0xE0, 0xC0, 0x80, 0x00, 0x00, 0x00, 0xF0, 0xFC, 0xFF, 0xFF, 0xFF, 0xFF, 0xF9, 0xF1, 0xE3, 0xC7, 0x8F, 0x1F, 0x3F, 0x1F, 0x8F, 0xC7, 0xE3, 0xF1, 0xF9, 0xFF, 0xFF, 0xFF, 0xFF, 0xFC, 0xF0, 0x07, 0x1F, 0x7F, 0xFF, 0xFF, 0xFF, 0xCF, 0xC7, 0xE3, 0xF1, 0xF8, 0xFC, 0xFE, 0xFC, 0xF8, 0xF1, 0xE3, 0xC7, 0xCF, 0xFF, 0xFF, 0xFF, 0x7F, 0x1F, 0x07, 0x00, 0x00, 0x00, 0x00, 0x01, 0x03, 0x03, 0x07, 0x07, 0x0F, 0x0F, 0x0F, 0x0F, 0x0F, 0x0F, 0x0F, 0x07, 0x07, 0x03, 0x03, 0x01, 0x00, 0x00, 0x00, 0x00}
};

MAX35103 MAX;
valvulaMotorDC valvula;
displayST7565R LCD;

uint16_t avisos[qtdAvisos];

boolean novoAviso = false;

boolean LoRaConectado = false;

boolean ausenciaAgua = false;

double  volume = 0;
uint32_t ultimoFluxo = 0;
uint32_t ultimaTemperatura = 0;
uint32_t ultimaPressao = 0;

float fluxoMedido[15] = {0.0, 0.0, 0.0, 0.0, 0.0, 0.0, 0.0, 0.0, 0.0, 0.0, 0.0, 0.0, 0.0, 0.0, 0.0};
uint8_t indiceFluxo = 0;

uint8_t avisosQtd = 0;
uint8_t avisosIndice = 0;

uint8_t indiceDisplay = 0;
unsigned long millisAnteriorDisplay = 0;

boolean btnPressionado = false;

void logAviso(uint16_t _codigo) {
  novoAviso = true;

  for (uint8_t _i = 0; _i < qtdAvisos; _i++) {
    if (avisos[_i] == 0) {
      avisos[_i] = _codigo;
      return;
    }
  }

  for (uint8_t _i = 0; _i < (qtdAvisos - 1); _i++) {
    avisos[_i] = avisos[_i + 1];
  }

  avisos[qtdAvisos - 1] = _codigo;
}

// ### INICIO MAX35103 ###

/*uint16_t _dado = readFlash16(0x0000);
  Serial.print("_dado: ");
  Serial.println(_dado, HEX);
  delay(500);

  eraseFlash(0x0000);
  delay(100);

  while (interruptStatus(7) == 0) {
    delay(100);
  }
  Serial.println("Erase OK!");

  delay(500);

  _dado = readFlash16(0x0000);
  Serial.print("_dado: ");
  Serial.println(_dado, HEX);
  delay(500);

  writeFlash16(0x0000, 0x1234);
  delay(100);

  while (interruptStatus(7) == 0) {
    delay(100);
  }
  Serial.println("Write OK!");

  delay(500);

  _dado = readFlash16(0x0000);
  Serial.print("_dado: ");
  Serial.println(_dado, HEX);

  delay(500);*/

#if DEBUG
void printConfigMAX() {
  uint16_t _reg = MAX.readRegister16(0xB8);
  Serial.print(F("TOF1 0xB8: 0x"));
  Serial.println(_reg, HEX);

  _reg = MAX.readRegister16(0xB9);
  Serial.print(F("TOF2 0xB9: 0x"));
  Serial.println(_reg, HEX);

  _reg = MAX.readRegister16(0xBA);
  Serial.print(F("TOF3 0xBA: 0x"));
  Serial.println(_reg, HEX);

  _reg = MAX.readRegister16(0xBB);
  Serial.print(F("TOF4 0xBB: 0x"));
  Serial.println(_reg, HEX);

  _reg = MAX.readRegister16(0xBC);
  Serial.print(F("TOF5 0xBC: 0x"));
  Serial.println(_reg, HEX);

  _reg = MAX.readRegister16(0xBD);
  Serial.print(F("TOF6 0xBD: 0x"));
  Serial.println(_reg, HEX);

  _reg = MAX.readRegister16(0xBE);
  Serial.print(F("TOF7 0xBE: 0x"));
  Serial.println(_reg, HEX);

  _reg = MAX.readRegister16(0xBF);
  Serial.print(F("_reg 0xBF: 0x"));
  Serial.println(_reg, HEX);

  _reg = MAX.readRegister16(0xC0);
  Serial.print(F("_reg 0xC0: 0x"));
  Serial.println(_reg, HEX);

  _reg = MAX.readRegister16(0xC1);
  Serial.print(F("_reg 0xC1: 0x"));
  Serial.println(_reg, HEX);

  _reg = MAX.readRegister16(0xC2);
  Serial.print(F("_reg 0xC2: 0x"));
  Serial.println(_reg, HEX);
}
#endif

// ### FINAL MAX35103 ###

// ### INICIO DISPLAY ###

void PGMReadNumeros(unsigned char *_vetor, uint8_t _posicao) {
  for (uint8_t _i = 0; _i < 56; _i++) {
    _vetor[_i] = pgm_read_byte(&(numeros[_posicao][_i]));
  }
}

void PGMreadSimboloPonto(unsigned char *_vetor) {
  for (uint8_t _i = 0; _i < 8; _i++) {
    _vetor[_i] = pgm_read_byte(&(simboloPonto[_i]));
  }
}

void PGMreadSimboloM3(unsigned char *_vetor) {
  for (uint8_t _i = 0; _i < 60; _i++) {
    _vetor[_i] = pgm_read_byte(&(simboloM3[_i]));
  }
}

void PGMreadSimboloLMin(unsigned char *_vetor) {
  for (uint8_t _i = 0; _i < 168; _i++) {
    _vetor[_i] = pgm_read_byte(&(simboloLMin[_i]));
  }
}

void PGMreadSimboloCelsius(unsigned char *_vetor) {
  for (uint8_t _i = 0; _i < 48; _i++) {
    _vetor[_i] = pgm_read_byte(&(simboloCelsius[_i]));
  }
}

void PGMreadSimboloBar(unsigned char *_vetor) {
  for (uint8_t _i = 0; _i < 108; _i++) {
    _vetor[_i] = pgm_read_byte(&(simboloBar[_i]));
  }
}

void PGMreadSimboloAviso(unsigned char *_vetor, boolean _erro) {
  for (uint8_t _i = 0; _i < 100; _i++) {
    _vetor[_i] = pgm_read_byte(&(simboloAviso[_erro][_i]));
  }
}

// _volumeInt deve ser um numero uint32_t formado pelo volume em float multiplicado por 10, ou seja, a unidade sera exibida como casa decimal
void volumeLCD(uint32_t _volumeInt) {
  String _string = "";

  if (_volumeInt < 100000) {
    _string.concat("0");
  }
  if (_volumeInt < 10000) {
    _string.concat("0");
  }
  if (_volumeInt < 1000) {
    _string.concat("0");
  }
  if (_volumeInt < 100) {
    _string.concat("0");
  }
  if (_volumeInt < 10) {
    _string.concat("0");
  }
  
  _string.concat(_volumeInt);
  uint32_t _length = _string.length();

  unsigned char _char [60] = {};

  PGMReadNumeros(_char, _string[_length - 6] - '0');
  LCD.writeNumber(_char, 0);

  PGMReadNumeros(_char, _string[_length - 5] - '0');
  LCD.writeNumber(_char, 18);
  
  PGMReadNumeros(_char, _string[_length - 4] - '0');
  LCD.writeNumber(_char, 36);
  
  PGMReadNumeros(_char, _string[_length - 3] - '0');
  LCD.writeNumber(_char, 54);
  
  PGMReadNumeros(_char, _string[_length - 2] - '0');
  LCD.writeNumber(_char, 72);

  // simbolo de . (ponto decimal)
  PGMreadSimboloPonto(_char);
  LCD.writeSymbol(_char, 89, 2); // 2 colunas no display
  
  PGMReadNumeros(_char, _string[_length - 1] - '0');
  LCD.writeNumber(_char, 94);
  
  // simbolo de m3 (metro cubico)
  PGMreadSimboloM3(_char);
  LCD.writeSymbol(_char, 113, 15); // 15 colunas no display
}

// _fluxoInt deve ser um numero uint32_t formado pelo fluxo em float multiplicado por 10, ou seja, a unidade sera exibida como casa decimal
void fluxoLCD(uint32_t _fluxoInt, uint8_t _inicio) {
  String _string = "";

  if (_fluxoInt < 100) {
    _string.concat("0");
  }
  if (_fluxoInt < 10) {
    _string.concat("0");
  }
  
  _string.concat(_fluxoInt);
  uint32_t _length = _string.length();

  unsigned char _char [168] = {};
  
  PGMReadNumeros(_char, _string[_length - 3] - '0');
  LCD.writeNumber(_char, _inicio);
  
  PGMReadNumeros(_char, _string[_length - 2] - '0');
  LCD.writeNumber(_char, _inicio + 18);

  // simbolo de . (ponto decimal)
  PGMreadSimboloPonto(_char);
  LCD.writeSymbol(_char, _inicio + 35, 2); // 2 colunas no display
  
  PGMReadNumeros(_char, _string[_length - 1] - '0');
  LCD.writeNumber(_char, _inicio + 40);
  
  // simbolo de L/MIN (litro por minuto)
  PGMreadSimboloLMin(_char);
  LCD.writeSymbol(_char, _inicio + 59, 42); // 42 colunas no display
}

// _tempInt deve ser um numero uint32_t formado pela temperatura em float multiplicado por 10, ou seja, a unidade sera exibida como casa decimal
void temperaturaLCD(uint32_t _tempInt, uint8_t _inicio) {
  String _string = "";

  if (_tempInt < 100) {
    _string.concat("0");
  }
  if (_tempInt < 10) {
    _string.concat("0");
  }
  
  _string.concat(_tempInt);
  uint32_t _length = _string.length();

  unsigned char _char [56] = {};
  
  PGMReadNumeros(_char, _string[_length - 3] - '0');
  LCD.writeNumber(_char, _inicio);
  
  PGMReadNumeros(_char, _string[_length - 2] - '0');
  LCD.writeNumber(_char, _inicio + 18);

  // simbolo de . (ponto decimal)
  PGMreadSimboloPonto(_char);
  LCD.writeSymbol(_char, _inicio + 35, 2); // 2 colunas no display
  
  PGMReadNumeros(_char, _string[_length - 1] - '0');
  LCD.writeNumber(_char, _inicio + 40);
  
  // simbolo de ºC (celsius)
  PGMreadSimboloCelsius(_char);
  LCD.writeSymbol(_char, _inicio + 59, 12); // 12 colunas no display
}

// _presaoInt deve ser um numero uint32_t formado pela temperatura em float multiplicado por 10, ou seja, a unidade sera exibida como casa decimal
void pressaoLCD(uint32_t _presaoInt, uint8_t _inicio) {
  String _string = "";

  if (_presaoInt < 100) {
    _string.concat("0");
  }
  if (_presaoInt < 10) {
    _string.concat("0");
  }
  
  _string.concat(_presaoInt);
  uint32_t _length = _string.length();

  unsigned char _char [108] = {};
  
  PGMReadNumeros(_char, _string[_length - 3] - '0');
  LCD.writeNumber(_char, _inicio);
  
  PGMReadNumeros(_char, _string[_length - 2] - '0');
  LCD.writeNumber(_char, _inicio + 18);

  // simbolo de . (ponto decimal)
  PGMreadSimboloPonto(_char);
  LCD.writeSymbol(_char, _inicio + 35, 2); // 2 colunas no display
  
  PGMReadNumeros(_char, _string[_length - 1] - '0');
  LCD.writeNumber(_char, _inicio + 40);
  
  // simbolo de bar
  PGMreadSimboloBar(_char);
  LCD.writeSymbol(_char, _inicio + 59, 27); // 27 colunas no display
}

// _codigo deve ser um numero uint32_t que indica o numero da mensagem e o parametro _erro indica se o simbolo sera de aviso ou erro
void avisoLCD(uint32_t _codigo, boolean _erro, uint8_t _inicio) {
  String _string = "";

  if (_codigo < 1000) {
    _string.concat("0");
  }
  if (_codigo < 100) {
    _string.concat("0");
  }
  if (_codigo < 10) {
    _string.concat("0");
  }
  
  _string.concat(_codigo);
  uint32_t _length = _string.length();

  unsigned char _char [100] = {};

  // simbolo de aviso ou erro
  PGMreadSimboloAviso(_char, _erro);
  LCD.writeSymbol(_char, _inicio, 25); // 25 colunas no display
  
  PGMReadNumeros(_char, _string[_length - 4] - '0');
  LCD.writeNumber(_char, _inicio + 29);
  
  PGMReadNumeros(_char, _string[_length - 3] - '0');
  LCD.writeNumber(_char, _inicio + 47);
  
  PGMReadNumeros(_char, _string[_length - 2] - '0');
  LCD.writeNumber(_char, _inicio + 65);

  PGMReadNumeros(_char, _string[_length - 1] - '0');
  LCD.writeNumber(_char, _inicio + 83);
}

// ### FINAL DISPLAY ###

// ### INICIO LORA

void enviaLora(String _pacote) {
  LoRa.beginPacket();
  LoRa.print(_pacote);
  LoRa.endPacket();

  #if DEBUG
  Serial.print("Enviado via LoRa: ");
  Serial.println(_pacote);
  #endif
}

boolean verificaPacoteLoRa(String _pacote) {
  uint8_t _tamanho = _pacote.length() + 1;
  char _data[_tamanho];
  _pacote.toCharArray(_data, _tamanho);

  if (_data[0] == '{' && _data[_tamanho - 2] == '}') {
    return true;
  }
  return false;
}

long leValorInt(String _pacote, uint8_t _indiceComando) {
  uint8_t _tamanho = _pacote.length() + 1;
  char _data[_tamanho];
  _pacote.toCharArray(_data, _tamanho);

  uint8_t _indiceSeparador = 0;
  for (uint8_t _i = _indiceComando + 1; _i < _tamanho - 2; _i++) {
    if (_data[_i] == ':') {
      _indiceSeparador = _i;
      break;
    }
  }

  uint8_t _indiceValor = 0;
  for (uint8_t _i = _indiceSeparador + 1; _i < _tamanho - 2; _i++) {
    if (_data[_i] - '0' >= 0 && _data[_i] - '0' <= 9) {
      _indiceValor = _i;
      break;
    }
  }

  String _valorString = "";
  for (uint8_t _i = _indiceValor; _i < _tamanho - 2; _i++) {
    if (_data[_i] - '0' >= 0 && _data[_i] - '0' <= 9) {
      _valorString.concat(_data[_i] - '0');
    }
    else {
      break;
    }
  }

  return _valorString.toInt();
}

void recebeLora() {
  #if DEBUG
  Serial.print(F("Recebido LoRa: "));
  #endif

  String _LoRaData = "";
  while (LoRa.available()) {
    _LoRaData.concat(LoRa.readString());
  }

  #if DEBUG
  Serial.println(_LoRaData);
  #endif

  if (verificaPacoteLoRa(_LoRaData)) {
    
    int _indiceComando = _LoRaData.indexOf("\"c\":");
    if (_indiceComando != -1) {

      uint8_t _valorInt = leValorInt(_LoRaData, _indiceComando);
      if (_valorInt == 1) {
        if(valvula.fecha()) {

          enviaLora("{\"c\":1, \"p\":\"ok\"}");

          #if DEBUG
          Serial.println(F("Valvula Fechada!"));
          #endif
        }
        else {
          logAviso(0x2009);

          #if DEBUG
          Serial.println(F("Falha ao fechar valvula!"));
          #endif
        }
      }
      else if (_valorInt == 2) {
        if(valvula.abre()) {

          enviaLora("{\"c\":2, \"p\":\"ok\"}");

          #if DEBUG
          Serial.println(F("Valvula Aberta!"));
          #endif
        }
        else {
          logAviso(0x200A);

          #if DEBUG
          Serial.println(F("Falha ao abrir valvula!"));
          #endif
        }
      }
      else if (_valorInt == 3) {

        int _indiceComandoP = _LoRaData.indexOf("\"p\":");
        if (_indiceComandoP != -1) {

          uint32_t _valorIntP = leValorInt(_LoRaData, _indiceComandoP);
          if (_valorIntP) {

            if(valvula.abreParcial(_valorIntP)) {

              enviaLora("{\"c\":3, \"p\":\"ok\"}");

              #if DEBUG
              Serial.println(F("Valvula com Abertura Parcial!"));
              #endif
            }
            else {
              logAviso(0x200D);

              #if DEBUG
              Serial.println(F("Falha ao realizar abertura parcial da valvula!"));
              #endif
            }
          }
          else {
            logAviso(0x200C);

            #if DEBUG
            Serial.println(F("Falha! Tempo de abertura parcial incorreto ou nulo!"));
            #endif
          }
        }
        else {
          logAviso(0x200B);

          #if DEBUG
          Serial.println(F("Falha! Tempo de abertura parcial ausente!"));
          #endif
        }
      }
      else {
        logAviso(0x2008);

        #if DEBUG
        Serial.println(F("Falha! Comando LoRa desconhecido!"));
        #endif
      }
    }
    else {
      logAviso(0x2007);

      #if DEBUG
      Serial.println(F("Falha! Pacote LoRa desconhecido!"));
      #endif
    }
  }
  else {
    logAviso(0x2006);

    #if DEBUG
    Serial.println(F("Erro no pacote LoRa recebido!"));
    #endif
  }
}

void enviaAvisosLoRa() {
  uint8_t _size = 0;
  for (uint8_t _i = 0; _i < qtdAvisos; _i++) {
    if (avisos[_i] != 0) {
      _size = _i + 1;
    }
    else {
      _i = qtdAvisos;
    }
  }

  if (_size) {
    String _lora = "{\"o\":\"a\", \"t\":[";

    for (uint8_t _i = 0; _i < _size; _i++) {
      _lora.concat("0x");
      String _codigo = String(avisos[_i], HEX);
      _codigo.toUpperCase();
      _lora.concat(_codigo);
      if (_i < _size - 1) {
        _lora.concat(", ");
      }
    }
    _lora.concat("]}");
    enviaLora(_lora);
    
    #if DEBUG
    Serial.println(F("OK!"));
    #endif
  }
  #if DEBUG
  else {
    Serial.println(F("Sem Avisos"));
  }
  #endif
}

void limpaAvisos() {
  for (uint8_t _i = 0; _i < qtdAvisos; _i++) {
    avisos[_i] = 0;
  }
}

// ### FINAL LORA ###

void displayInfo() {
  if (indiceDisplay == 0 && avisosQtd == 0 && avisosIndice == 0) {
    for (uint8_t _i = 0; _i < qtdAvisos; _i++) {
      if (avisos[_i] != 0) {
        avisosQtd = _i + 1;
      }
      else {
        _i = qtdAvisos;
      }
    }

    #if DEBUG
    Serial.print(F("avisosQtd: "));
    Serial.println(avisosQtd);
    #endif
  }

  if (indiceDisplay == 0) {
    if (avisosIndice < avisosQtd) {
      boolean _erro = false;
      uint8_t _tipo = avisos[avisosIndice] >> 12;
      if (_tipo >= 0x3) {
        _erro = true;
      }

      #if DEBUG
      Serial.print(F("_erro: "));
      Serial.print(_erro);
      Serial.print(F(" | _cod: 0x"));
      Serial.println(avisos[avisosIndice] & 0xFFF, HEX);
      #endif

      LCD.clear(0, 128);
      delay(1);
      avisoLCD(avisos[avisosIndice] & 0xFFF, _erro, 15);
      avisosIndice++;

      millisAnteriorDisplay = millis();
    }
    else {
      indiceDisplay++;
    }
  } 
  
  if (indiceDisplay) {
    
    LCD.clear(0, 128);
    delay(1);

    switch (indiceDisplay) {
      case 1:
        volumeLCD(uint32_t(volume / 100.00));
        break;

      case 2:
        fluxoLCD(ultimoFluxo, 14); // inicio em 14
        break;

      case 3:
        temperaturaLCD(ultimaTemperatura, 29); // inicio em 29
        break;

      case 4:
        pressaoLCD(ultimaPressao, 21); // inicio em 21
        break;
    }

    if (indiceDisplay >= 5) {
      LCD.clear(0, 128);
      delay(1);

      avisosQtd = 0;
      avisosIndice = 0;
      indiceDisplay = 0;
      millisAnteriorDisplay = 0;
    }
    else {
      indiceDisplay++;

      millisAnteriorDisplay = millis();
    }
  }
}

void setup() {
  #if DEBUG
  Serial.begin(115200);
  delay(10);
  Serial.println(F("\n\nIniciando..."));
  #endif

  LCD.begin(LCD_SI, LCD_SCL, LCD_A0, LCD_RST, LCD_CS);
  delay(10);
  LCD.clear(0, 128);

  pinMode(LCD_LED, OUTPUT);
  digitalWrite(LCD_LED, HIGH);
  delay(100);
  digitalWrite(LCD_LED, LOW);

  pinMode(btnPin, INPUT);
  //digitalWrite(btnPin, HIGH); // Pullup externo

  pinMode(pressaoPin, INPUT);

  limpaAvisos();

  logAviso(avisoInicio); // Inicio do programa

  SPI.begin();

  delay(100);
  MAX.begin(MAX35103INT, MAX35103RST, MAX35103CE);

  delay(100);
  if (!MAX.reset()) {
    logAviso(0x3002);
    
    #if DEBUG
    Serial.println(F("ERRO no Reset do MAX35103"));
    #endif
  }
  #if DEBUG
  else {
    Serial.println(F("MAX35103 Reset OK!"));
  }
  #endif

  delay(100);
  MAX.config();

  #if DEBUG
  delay(100);
  printConfigMAX();
  #endif

  delay(100);
  if (!MAX.toFlash()) {
    logAviso(0x3003);

    #if DEBUG
    Serial.println(F("ERRO no toFlash do MAX35103"));
    #endif
  }
  #if DEBUG
  else {
    Serial.println(F("MAX35103 toFlash OK!"));
  }
  #endif
  
  delay(100);
  if (!MAX.initialize()) {
    logAviso(0x3004);

    #if DEBUG
    Serial.println(F("ERRO no initialize do MAX35103"));
    #endif
  }
  #if DEBUG
  else {
    Serial.println(F("Initialize OK!"));
  }
  #endif

  digitalWrite(LCD_LED, HIGH);
  delay(100);
  digitalWrite(LCD_LED, LOW);
  delay(100);

  valvula.begin(SW1Pin, SW2Pin, motorSleepPin, motorIN1Pin, motorIN2Pin);
  
  if (!valvula.abre()) {
    logAviso(0x200A);
    
    #if DEBUG
    Serial.println(F("Falha ao abrir valvula!"));
    #endif
  }
  #if DEBUG
  else {
    Serial.println(F("Valvula aberta!"));
  }
  #endif

  digitalWrite(LCD_LED, HIGH);
  delay(100);
  digitalWrite(LCD_LED, LOW);
  delay(100);

  LoRa.setPins(LoRaSS, LoRaRST, LoRaDIO0);

  uint8_t _timeout = 0;
  while (!LoRa.begin(868E6) && _timeout < 5) {
    _timeout++;
    delay(1000);
  }

  if (_timeout >= 5) {
    
    logAviso(0x2005);

    #if DEBUG
    Serial.println(F("Falha ao iniciar modulo LoRa!"));
    #endif
  }
  else {
    LoRaConectado = true;

    #if DEBUG
    Serial.println(F("Modulo LoRa iniciado!"));
    #endif
  }

  LoRa.setTxPower(20);

  // Change sync word (0xAF) to match the receiver
  // The sync word assures you don't get LoRa messages from other LoRa transceivers
  // ranges from 0-0xFF
  LoRa.setSyncWord(0xAF);

  #if DEBUG
  Serial.println(F("Setup OK!"));
  #endif

  digitalWrite(LCD_LED, HIGH);
  delay(100);
  digitalWrite(LCD_LED, LOW);

  MAX.startEVTMG1();
}

void loop() {
  
  if (!digitalRead(MAX35103INT)) {
    delay(50);
    if (!digitalRead(MAX35103INT)) {
      
      boolean _tof = false;
      boolean _temp = false;
      uint16_t intEVTMG = MAX.verificaIntEVTMG(&_temp, &_tof);

      if(_tof) {
        float _fluxo = MAX.leFluxoToFDIffAVG();

        volume += (double)_fluxo / 10.00; // volume em litros
        ultimoFluxo = uint32_t(_fluxo * 10.0);

        fluxoMedido[indiceFluxo] = _fluxo;
        indiceFluxo++;

        #if DEBUG
        Serial.print("_fluxo: ");
        Serial.println(_fluxo);
        #endif
      }

      if(_temp) {
        float _tempT1 = 0.0;
        boolean _tempOK = MAX.tempT1AVG(&_tempT1);

        ultimaTemperatura = uint32_t(_tempT1 * 10.0);
    
        #if DEBUG
        if (_tempOK) {
          Serial.print("_tempT1 EVT: ");
          Serial.println(_tempT1, 1);
        }
        else {
          Serial.println(F("Erro ao ler temperatura!"));
        }
        #endif

        uint32_t _pressaoAnalog = analogRead(pressaoPin);
        float _pressaoPSI = ((float)_pressaoAnalog - 90.086) / 4.1137;
        float _pressaoBar = _pressaoPSI / 14.504;

        ultimaPressao = uint32_t(_pressaoBar * 10.0);

        #if DEBUG
        Serial.print("pressao: ");
        Serial.print(_pressaoPSI);
        Serial.print(" PSI | ");
        Serial.print(_pressaoBar);
        Serial.println(" bar");
        #endif

        if (!ausenciaAgua && _pressaoBar < 0.25) {
          ausenciaAgua = true;
          logAviso(0x200E);
          #if DEBUG
          Serial.println(F("### Ausencia de agua! ###"));
          #endif
        }

        if (ausenciaAgua && _pressaoBar >= 0.25) {
          ausenciaAgua = false;
          logAviso(0x100F);
          #if DEBUG
          Serial.println(F("Pressao normalizada!"));
          #endif
        }

        if (LoRaConectado) {
          String _pacote = "{\"o\": \"t\", \"v\": [";
          _pacote.concat(String(volume, 0));
          _pacote.concat("], \"f\": [");
          for (uint8_t _i = 0; _i < indiceFluxo; _i++) {
            _pacote.concat(String(fluxoMedido[_i], 2));
            if (_i < indiceFluxo - 1) {
              _pacote.concat(", ");
            }
            fluxoMedido[_i] = 0.0;
          }
          indiceFluxo = 0;
          _pacote.concat("], \"t\": [");
          if (_tempOK) {
            _pacote.concat(String(_tempT1, 2));
          }
          else {
            _pacote.concat("0.00");
          }
          _pacote.concat("], \"p\": [");
          _pacote.concat(String(_pressaoBar, 2));
          _pacote.concat("]}");

          enviaLora(_pacote);
        }
      }
      
      if (intEVTMG & (1 << 15)) {

        if (LoRaConectado) {
          enviaLora("{\"o\": \"t\", \"f\": [00.00]}");
        }
        
        #if DEBUG
        Serial.println("intEVTMG Timeout!");
        #endif
      }
    }
  }

  if (!btnPressionado && !digitalRead(btnPin)) {
    delay(20);
    if (!digitalRead(btnPin)) {
      displayInfo();
      btnPressionado = true;
    }
  }

  if (btnPressionado && digitalRead(btnPin)) {
    delay(20);
    if (digitalRead(btnPin)) {
      btnPressionado = false;
    }
  }

  if (millisAnteriorDisplay) {
    if (millis() > millisAnteriorDisplay + tempoInfoLCD) {
      indiceDisplay = 5;
      displayInfo();
    }
  }

  if (LoRaConectado) {
    if (LoRa.parsePacket()) {
      recebeLora();
    }
    
    if (novoAviso) {
      #if DEBUG
      Serial.println(F("Enviando avisos..."));
      #endif
      
      enviaAvisosLoRa();
      limpaAvisos();
      novoAviso = false;
    }
  }

  delay(10);
}
