OrigamiTeam/AquaFlow/Teste Display NHD-C12832A1Z/src/main.cpp

#include <Arduino.h>

/*#define SI 15 // Serial data signal
#define SC 16 // Serial clock signal
#define RS 17 // Register select signal
#define RES 18 // Reset signal
#define CS 19  // Chip select signal*/

#include <U8g2lib.h>

#ifdef U8X8_HAVE_HW_SPI
#include <SPI.h>
#endif
#ifdef U8X8_HAVE_HW_I2C
#include <Wire.h>
#endif

/*
  U8g2lib Example Overview:
    Frame Buffer Examples: clearBuffer/sendBuffer. Fast, but may not work with all Arduino boards because of RAM consumption
    Page Buffer Examples: firstPage/nextPage. Less RAM usage, should work with all Arduino boards.
    U8x8 Text Only Example: No RAM usage, direct communication with display controller. No graphics, 8x8 Text only.
    
*/

// Please UNCOMMENT one of the contructor lines below
// U8g2 Contructor List (Frame Buffer)
// The complete list is available here: https://github.com/olikraus/u8g2/wiki/u8g2setupcpp
// Please update the pin numbers according to your setup. Use U8X8_PIN_NONE if the reset pin is not connected

U8G2_ST7565_NHD_C12832_F_4W_SW_SPI u8g2(U8G2_R2, /* clock=*/ 16, /* data=*/ 15, /* cs=*/ 19, /* dc=*/ 17, /* reset=*/ 18);
//U8G2_ST7565_NHD_C12832_F_4W_HW_SPI u8g2(U8G2_R0, /* cs=*/ 10, /* dc=*/ 9, /* reset=*/ 8);

void setup(void) {
  u8g2.begin();
}

void loop(void) {
  u8g2.clearBuffer();
  u8g2.setFont(u8g2_font_ncenB18_tr);
  u8g2.drawStr(0,20, "000000.00");
  u8g2.sendBuffer();
  delay(1000);
}
