OrigamiTeam/AquaFlow/(commit log)

2024-07-17 Ajustes de organizacao
    [SmartFlow v0.1 BOM JLC.xlsx, SmartFlow v0.1 BOM PCBWay.xlsx, SmartFlow v0.1 PKP.csv, SmartFlow v0.1 [20240507, 19-59-03].pdsprj, SmartFlow v0.1 [20240507, 19-59-58].pdsprj, SmartFlow v0.1 [20240507, 20-02-23].pdsprj, SmartFlow v0.1 [20240509, 10-16-51].pdsprj, SmartFlow v0.1 [20240509, 10-20-16].pdsprj]
2024-07-23 SW para CIs Texas
2024-07-24 Atividades diarias
    [T-2Y2W539394A-5sets-SmartFlow+v0.1+BOM+PCBWay(2024-05-27).xlsx]
2024-08-14 MAX35103 realizando leituras de ToF Diff
